gfannes/klepto/Proposal.md

&done

De massale aanval van laffe aliens op onze Mars basis kwam totaal onverwacht. Jij hebt het gelukkig wel overleefd, samen met enkele collega's en wat basis materiaal. Help je om snel iets in elkaar knutselen en het voortbestaan van de mensheid op Mars te garanderen? Neem best ook een mama of papa mee: terwijl jij wilde ideeën tegen de lichtsnelheid knalt, kan die voor snacks zorgen en effectief de handleiding lezen.

In deze workshop maken we een heuse Mars rover met een echte Rocker-Bogie ophanging op basis van [STEMFIE](https://stemfie.org/) 3D-geprint materiaal. De aandrijving komt van enkele gehackte servo motoren. Dit alles toppen we af met een kanon dat vol-automatisch NERF darts kan afvuren. Ten slotte sturen we heel de boel aan via de Fri3d badge met behulp van NRF24L01 draadloze communicatie.

Kortom, teveel life-hacks en leer momenten om op te sommen. Alles is compatible met STEMFIE zodat je thuis rustig verder kan bouwen/printen/uitvinden/...

Doe je het liever wat rustiger aan: geen probleem, je kan evengoed boerderijdiertjes in elkaar knutselen. We weten allemaal dat patatjes goed groeien op Mars, waarom geen paarden en koeien?

Of ben je eerder een looser? Ook goed: dan kan je helpen om wat aliens in elkaar te knutselen. Met een tril-sensor, servo en een [digispark](https://www.kickstarter.com/projects/digistump/digispark-the-tiny-arduino-enabled-usb-dev-board) gaat deze alien neer wanneer die geraakt wordt door een NERF pijl.
