gfannes/klepto/&.md

&&klepto

https://docs.micropythonos.org/

Printlijst: https://docs.google.com/spreadsheets/d/1lR1KDpJ_HNhGDXhQdjOyAJ3Ws1VXYitcTHIAmVLh5S0/edit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

Working name to make the link with 'Mars rover'.
Alternatives:
- Lupin

# Tasks &#1
- [ ] Batteryholder under 5x9 clashes with L-beam screws
- [ ] Freewheel must be locked
- [ ] Tilt motor platte 6x3 L
- [ ] Rondellen voor centrale as en as 0.5U langer
- [ ] 5x5L for boogie

# MarsRover
- 1x P 9x5x1
- 2x T 11x2x1
- 2x L 3x4x1
- 2x T 3x7x1
- Frontwheel
	- 2x Freewheel
	- 2x L 5x5x1
	- 4x/6x wheel
- 1x L 6x3x0.25
- Battery holder
- MotorMount-v2
- Shooter
- Bolt 5 for shooter
- Axle 10.5
- Rubberbands
- Wheelfixer drivemotors
- 2x wheel + wheelfixer voor dubbele banden

- [x] Design deftige bandjes
- [ ] Label esp32 with mac address
- [ ] Create equipment list
	- [x] Order striptang
	- Lijmpistool
	- Soldeerbout
	- Fijnbektang
	- Striptang
	- Cuttermes
	- Ductape
	- Fijn platte schroevendraaier
	- Multimeter
	- Schuifpasser
	- Batterijlader
	- Labovoeding
	- Papier
	- Balpennen
- [x] Bestel filament
- [ ] Charge batteries
- [ ] Draw cart design
- [ ] Create box per rover
- [ ] Spare parts
- [ ] Zoek alle badges
- [ ] Solder JST to batterypacks
- [ ] Design target
