gfannes/klepto/Rover.md

&#5

# Suspension
- Rocker-bogie suspension of Mars rover
	- Diff with ropes: at 5min in https://www.youtube.com/watch?v=ern5a-jvdxY&t=332s
	- https://www.youtube.com/watch?v=dts8WvfQUDg
	- Too complex, couple front and rear wheel with rubber band to create basic suspension

# Parts
- [ ] Make complete rover body
- 2x 5x9 square
- 4x 3 beam thread with only middle hole
- 2x 13 beam
- 4x wheel
- 2x T1 wheel fixer
- 2x T1 motor mount
- 4x angle bracket
	- [ ] bit smaller to avoid hindering the base plate
- 4x poullies
- 2x4 1.5U screw and nut
- 2x axle fixer
- 1x axle
- 8x 1.5U screw for angle brackets
- 4x 1.25U screw
- 2x 3 beam

# Splitnut
- Sphere 8.4
- Slit: 12.8x3.4 6x3.8,B0.7 3x4.8,B1.5
- Cylinder: 6.8
- Profile: 12.8x5.4 4x4.4 from bottom

# Wheel fixer
- [?] How can we fix the wheel to the fixer
	- Hotglue?
- Outer cylinder 12.5
- 4 cuts with cylinder 10 with center at distance 10
- Depth Wheel: 9
- Axle length: 8
- Axle width: 5.3 x 3.6 => 5.5 x 3.9
- Axle smallhole: 2 => 2.2
- Length: 8+9
- Fillet

# STEMFIE
- https://github.com/Cantareus/Stemfie_OpenSCAD

# Ledger
## Prototype 2026-06-10
- [ ] 5xAA NiMH works but is depleted after 10min, either due to the MG996R or the battery pack being too old. Test this.
- [ ] Rubber bands are necessary for the wheels to have enough grip. Test with TPU and hotglue.
	- [?] Two temp filament
