gfannes/klepto/Comms.md

- ESP-NOW is a wireless protocol between ESP-WROOM-32 MCUs
	- 600m range
	- [x] Test this

- [x] Check comms capability:
	- Arduino + NRF24L01: https://www.youtube.com/watch?v=7rcVeFFHcFM
	- Issues with NRF24L01: https://www.youtube.com/watch?v=Z7_Cy66Vnrc
	- https://www.instructables.com/NRF24L01-Tutorial-Arduino-Wireless-Communication/
	- https://howtomechatronics.com/projects/diy-arduino-rc-transmitter/
