gfannes/klepto/Turret.md

- Drive 2 130-size DC motors
- Switch them with an N-MOSFET or relay
# Flywheel
- Motors: 130-size DC
	- 3-6V, 1.2W, 17kRPM
	- Requires a capacitor
	- https://www.amazon.com.be/-/nl/Fasizi-10-stuks-DC-Arduino/dp/B09Z2B1F1V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
- N-MOSFET
	- IRLZ44N
		- https://opencircuit.be/product/irlz44n-mosfet-55v-47a
	- FQP30N06L
	- IRLB3034 (very low RDS(on), overkill but excellent)
	- IRLB8748PBF (very low RDS(on), overkill but excellent)
	- IRL540 works but get a bit hotter
	- Better not use a TIP120 darlington NPN since that loses 1V

# Nerf cannon with fuel
- https://makerworld.com/en/models/2179007-alcohol-nerf-cannon#profileId-2364657

# Nerf turret
- https://www.youtube.com/watch?v=3Ma5ZCZVQRs
- https://www.youtube.com/watch?v=ZnJ6_IrmszU
