gfannes/klepto/docs/index.md

# Rover build plan

## Shooter

### Shooter arm prepareren

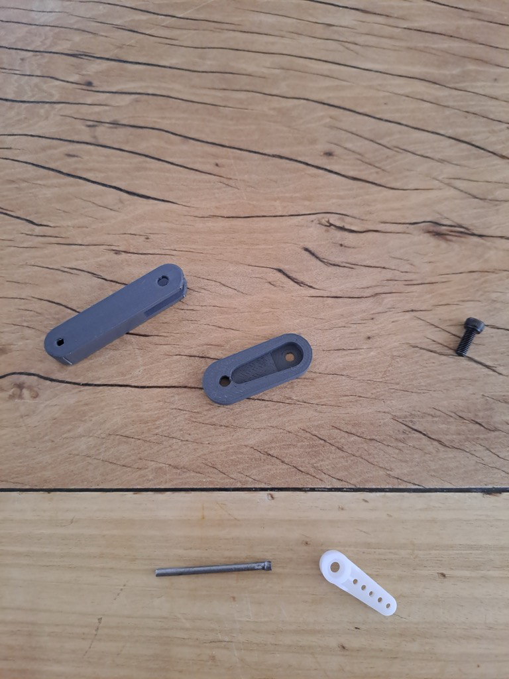
[picture p1: docs/img/A_s_05.jpg]

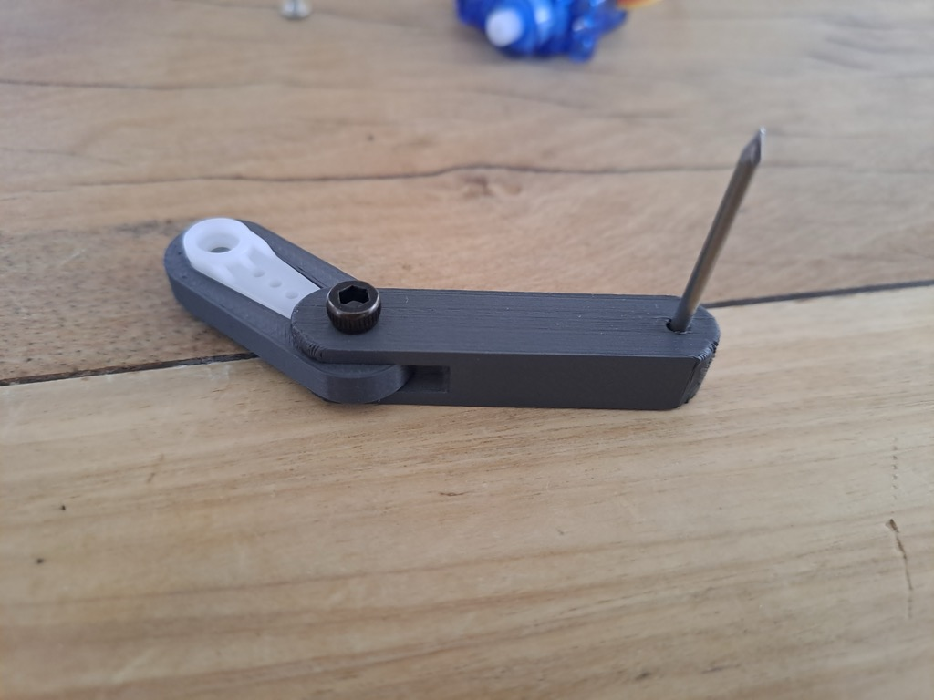
[picture p2: docs/img/A_s_06.jpg]

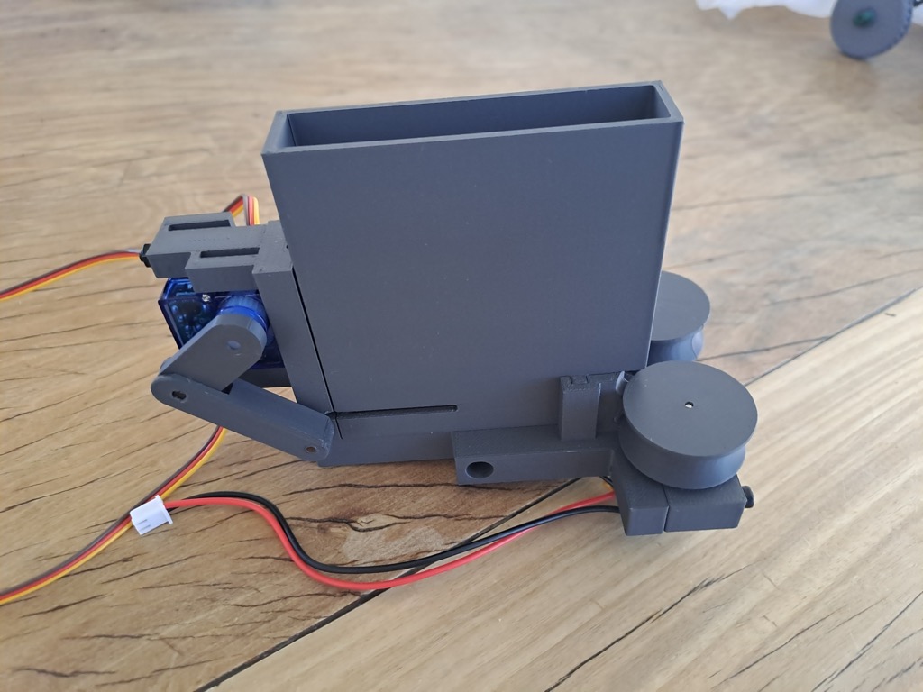
[picture p3: docs/img/A_s_07.jpg]

* Nagel opwarmen met aansteker om goed vast te smelten
    * Oppassen voor de vingers!!

### Servos aansluiten

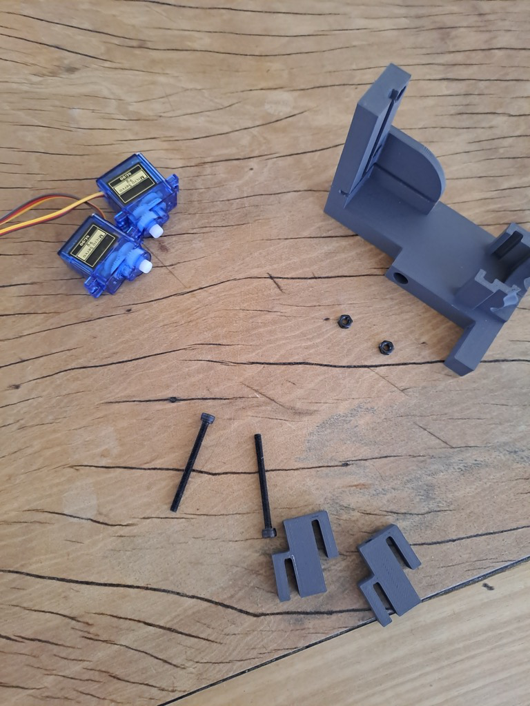
[picture p4: docs/img/A_s_00.jpg]


* Lange M3 bouten gebruiken (35 mm)

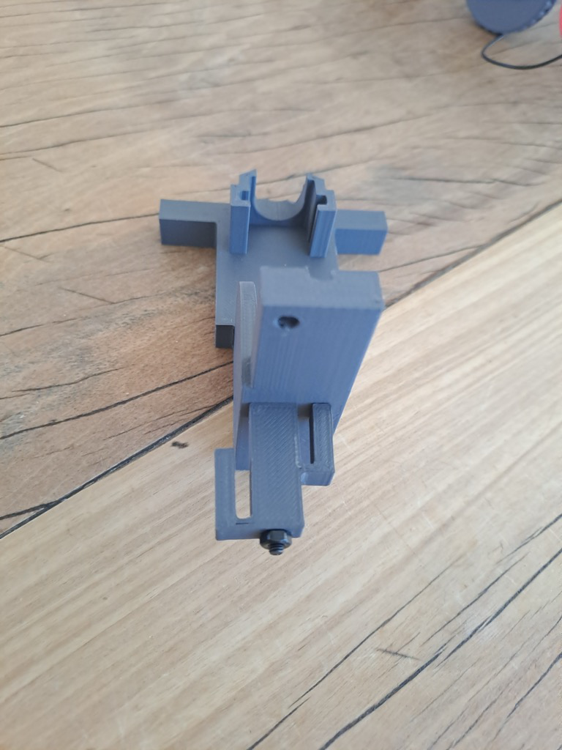
[picture p5: docs/img/A_s_01.jpg]


* Oppassen, de cactussen om de servo's te blokkeren zijn fragiel

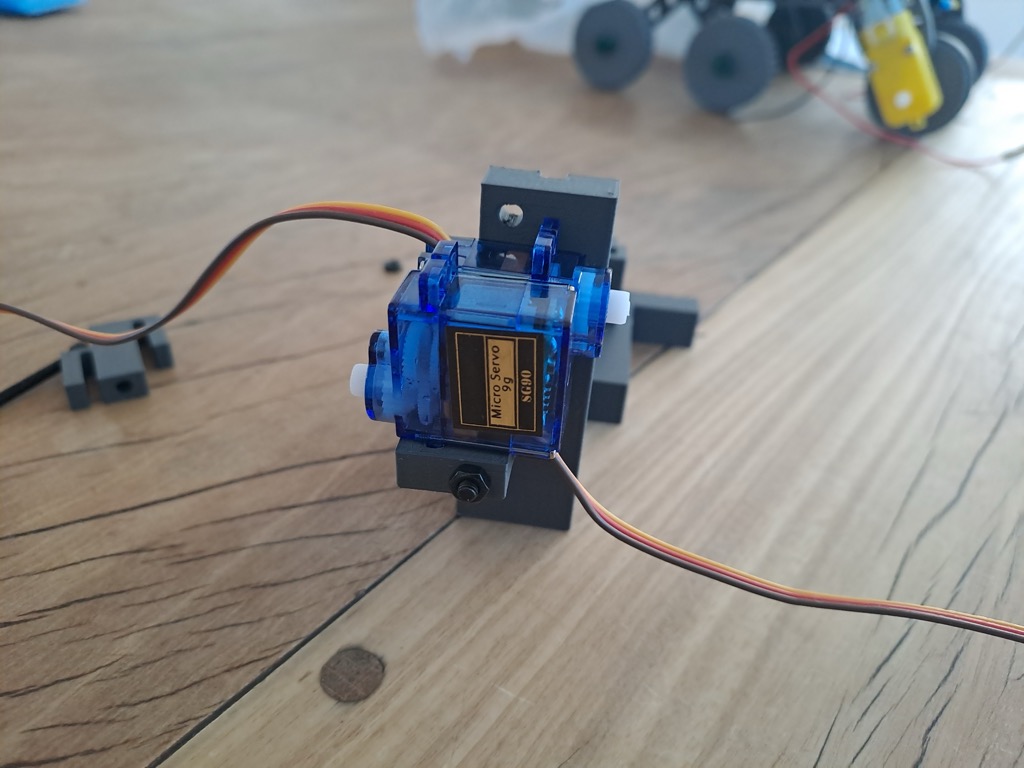
[picture p6: docs/img/A_s_02.jpg]


* Servo's correct positioneren

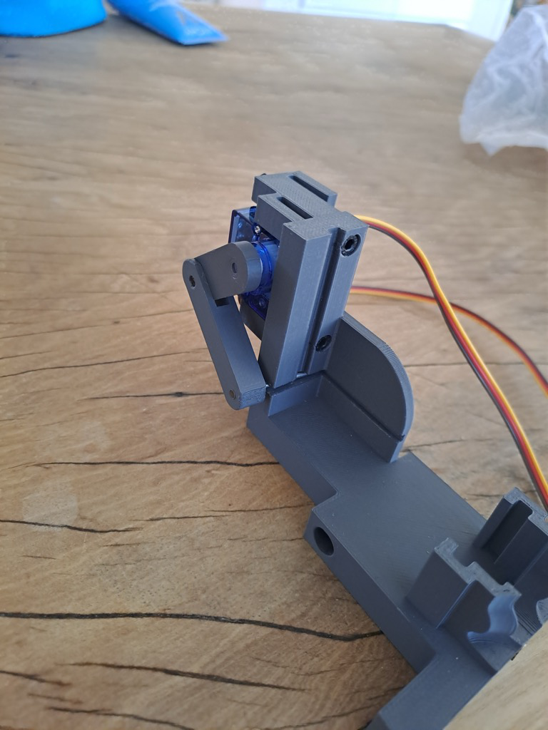
[picture p7: docs/img/A_s_03.jpg]


* Zorg dat de de ronde koppen van de M3s helemaal in de shooter base zitten

### Flywheels plaatsen

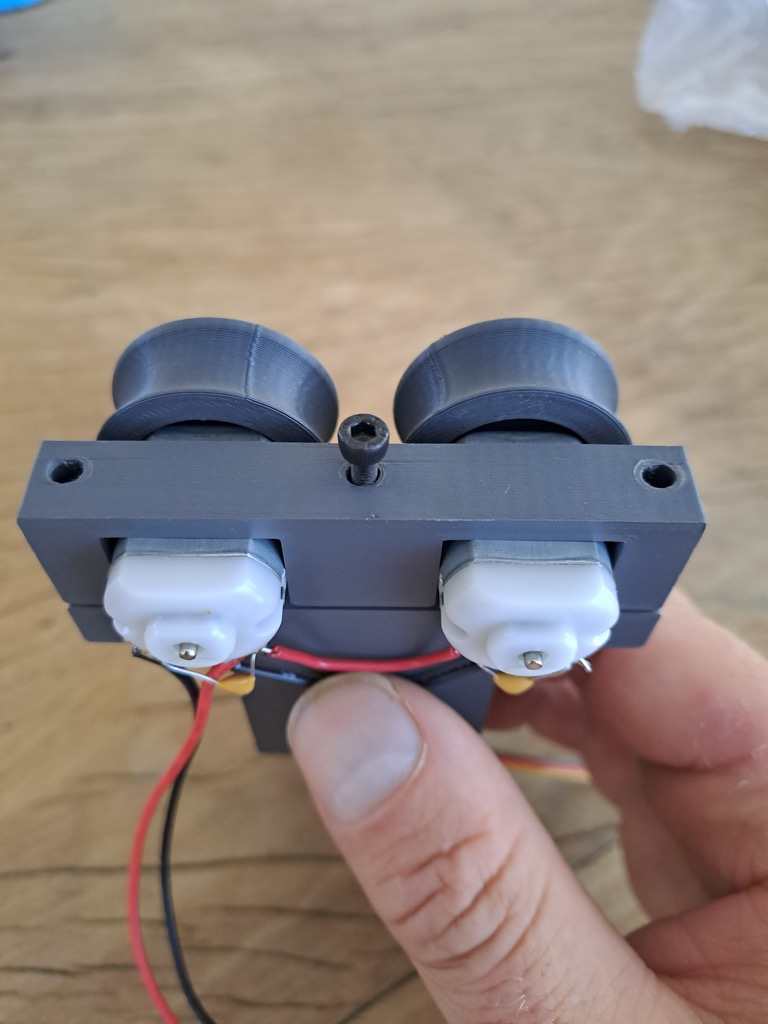
[picture p8: docs/img/A_s_04.jpg]


* Zorg dat de flywheels vrij kunnen draaien (test ook eens met de nerf pijltjes cartridge)

## Rocker arms

In tweevoud natuurlijk

### Aandrijf motoren

M3 van 25

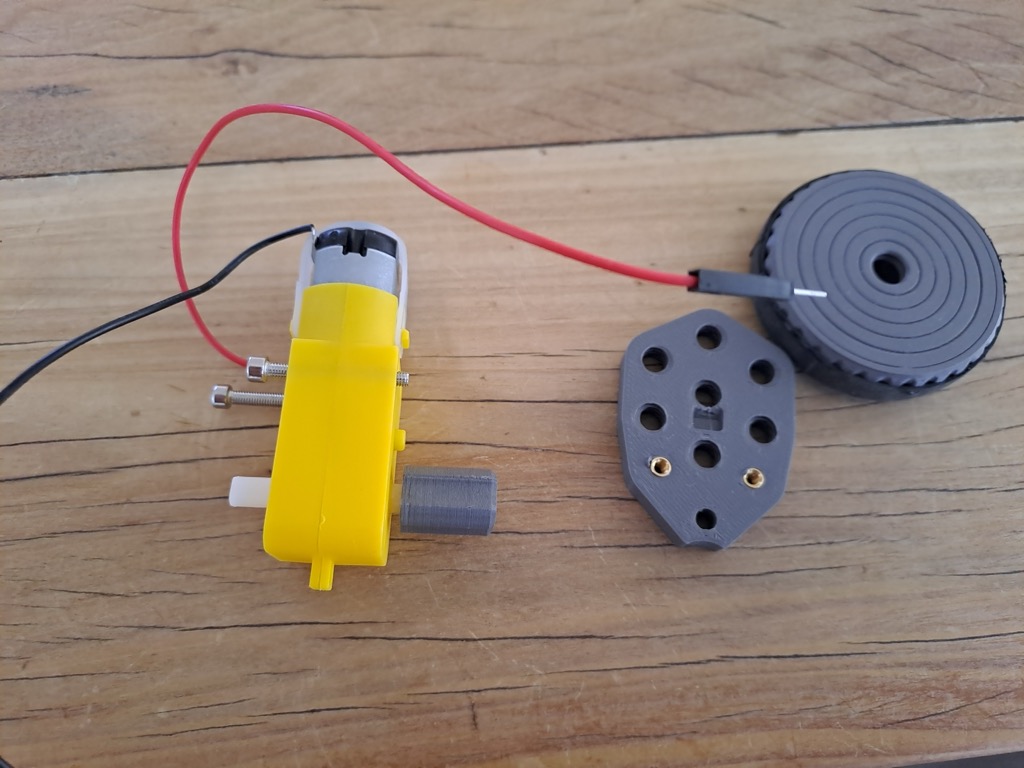
[picture p9: docs/img/B_m_00.jpg]

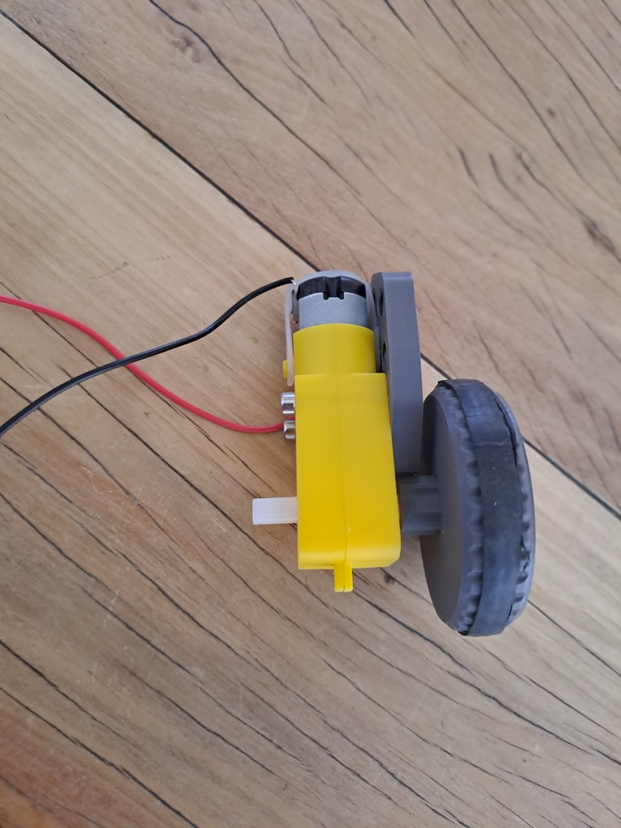
[picture p10: docs/img/B_m_01.jpg]


### Rocker wheel arms

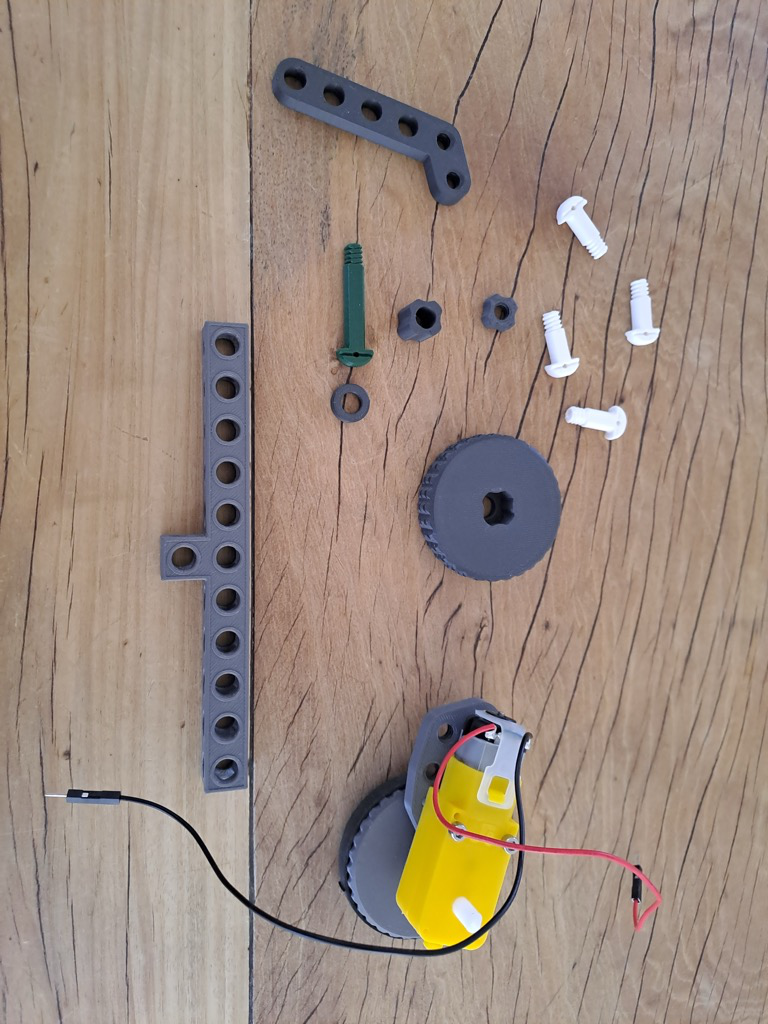
[picture p11: docs/img/B_sb_01.jpg]

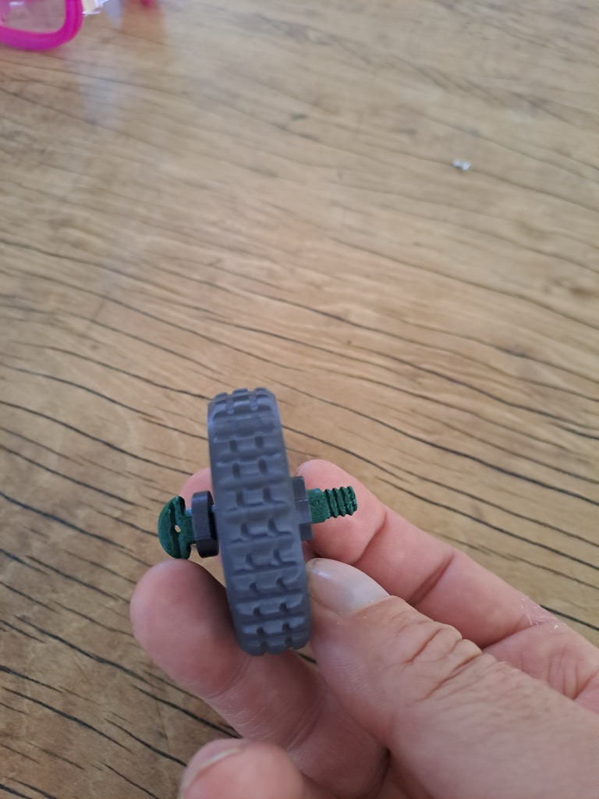
[picture p12: docs/img/B_sb_03.jpg]

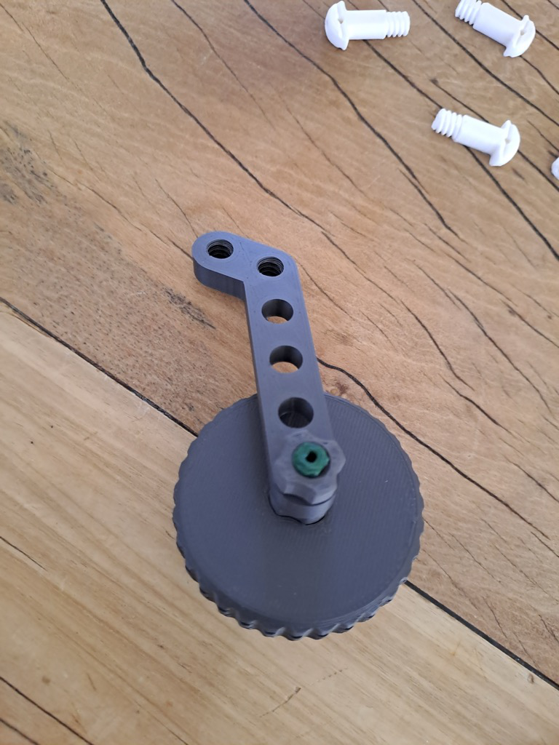
[picture p13: docs/img/B_sb_04.jpg]

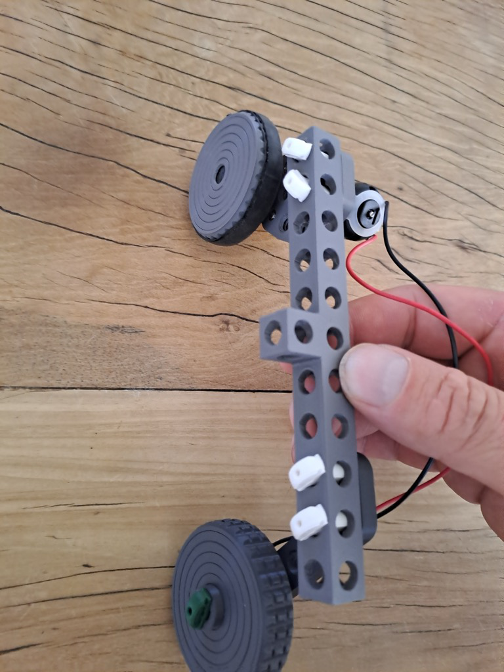
[picture p14: docs/img/B_sb_05.jpg]


### Kwalletjes

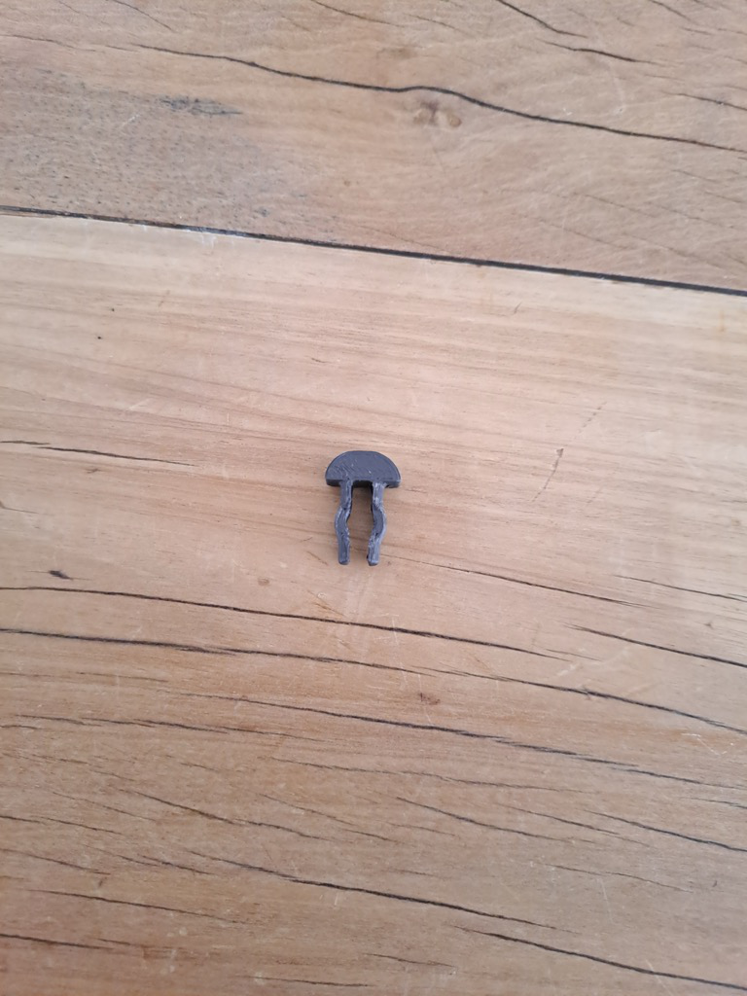
[picture p15: docs/img/kwal.jpg]


* Zorgt ervoor dat we pinnetje kunnen vastdraaien in een gatje
* Goed kijken, heeft een dunne en een dikke kant
    * Positionering is dus belangrijk

### Rocker suspension arms

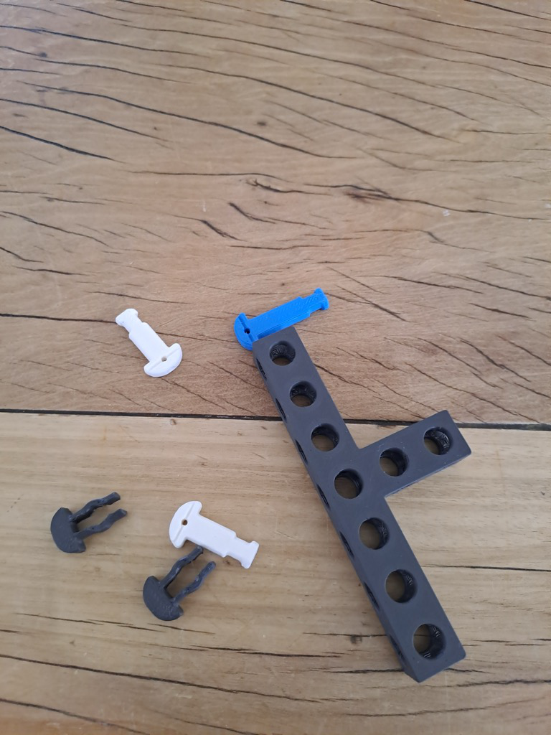
[picture p16: docs/img/B_fb_00.jpg]

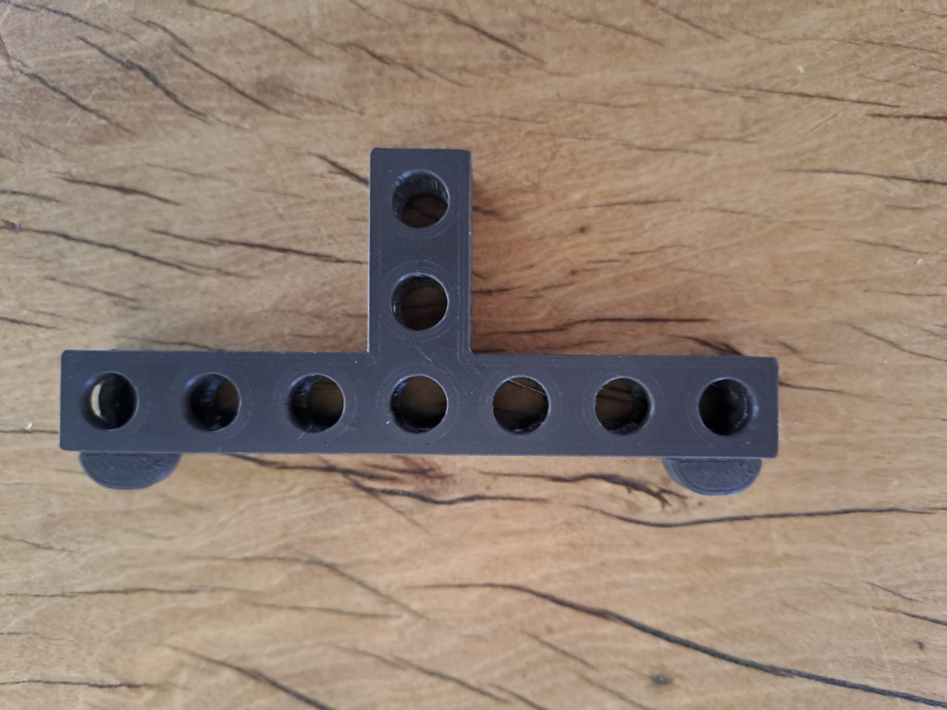
[picture p17: docs/img/B_fb_01.jpg]

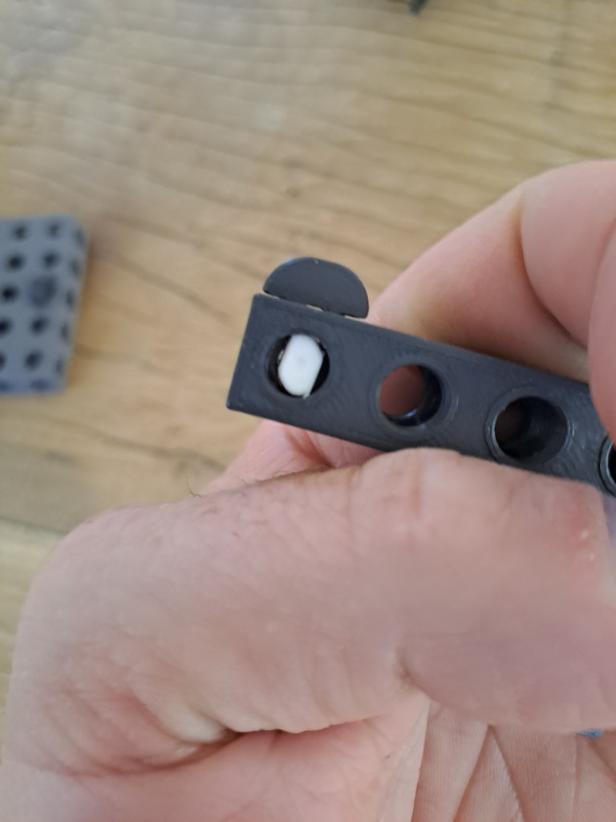
[picture p18: docs/img/B_fb_02.jpg]

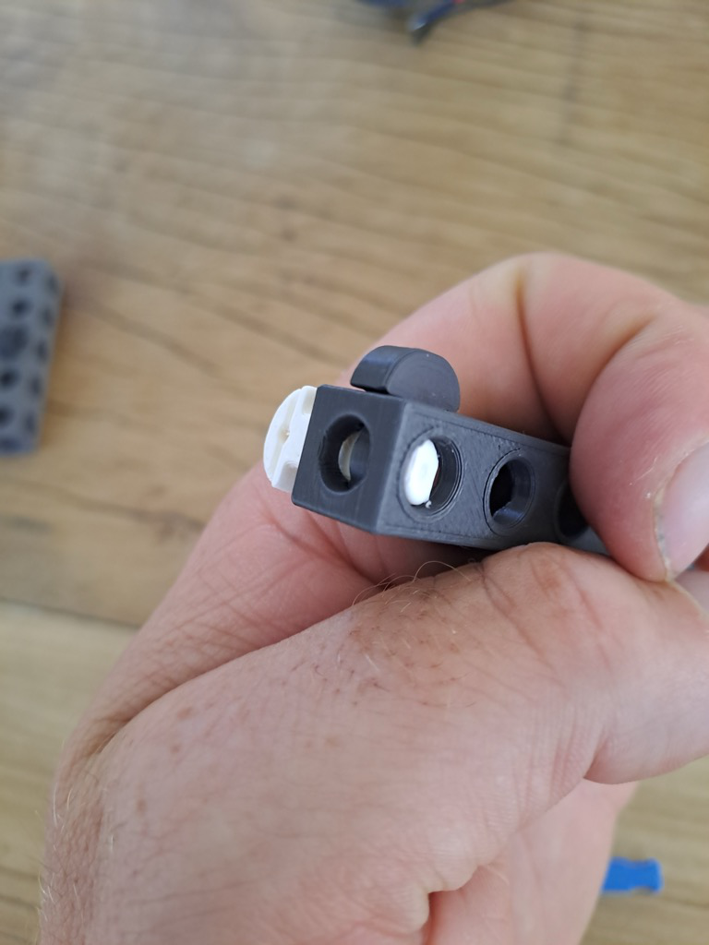
[picture p19: docs/img/B_fb_03.jpg]


* Witte pinnetjes steken wat uit, dienen om de vering op vast te maken

## Main body

### Shooter connection

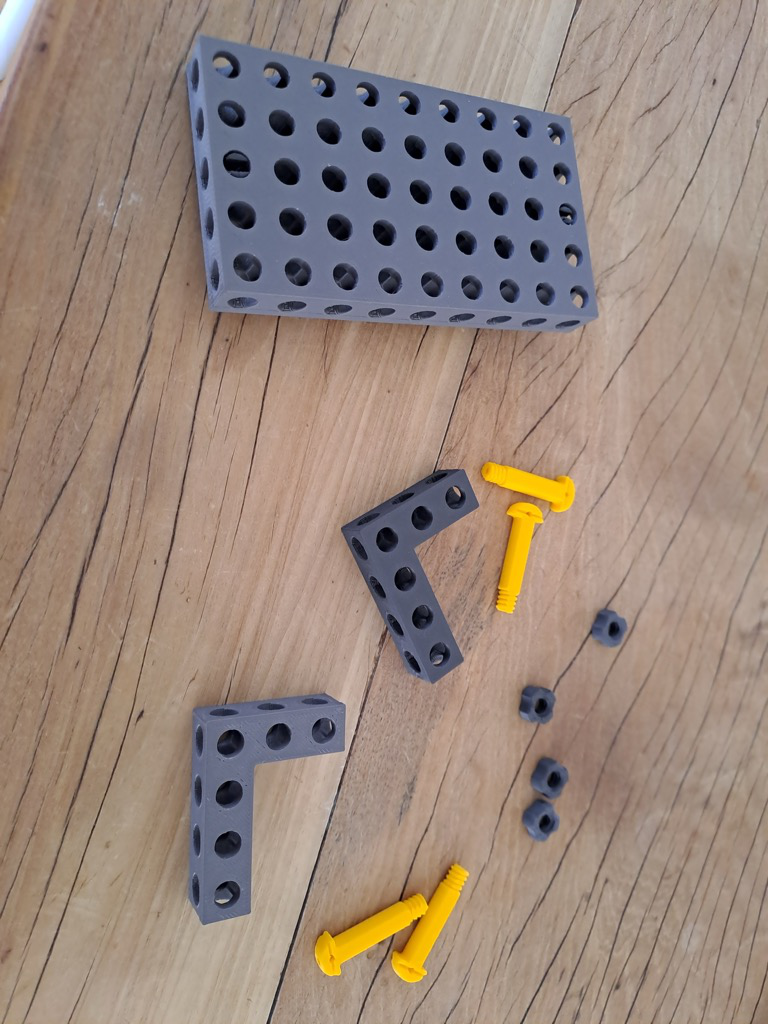
[picture p20: docs/img/C_bp_00.jpg]

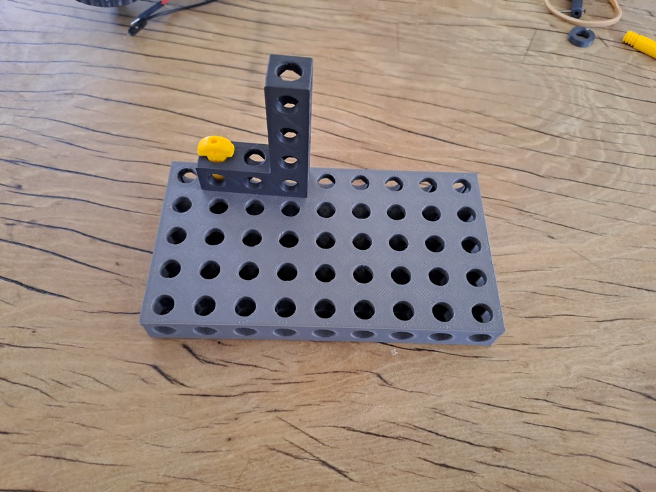
[picture p21: docs/img/C_bp_01.jpg]

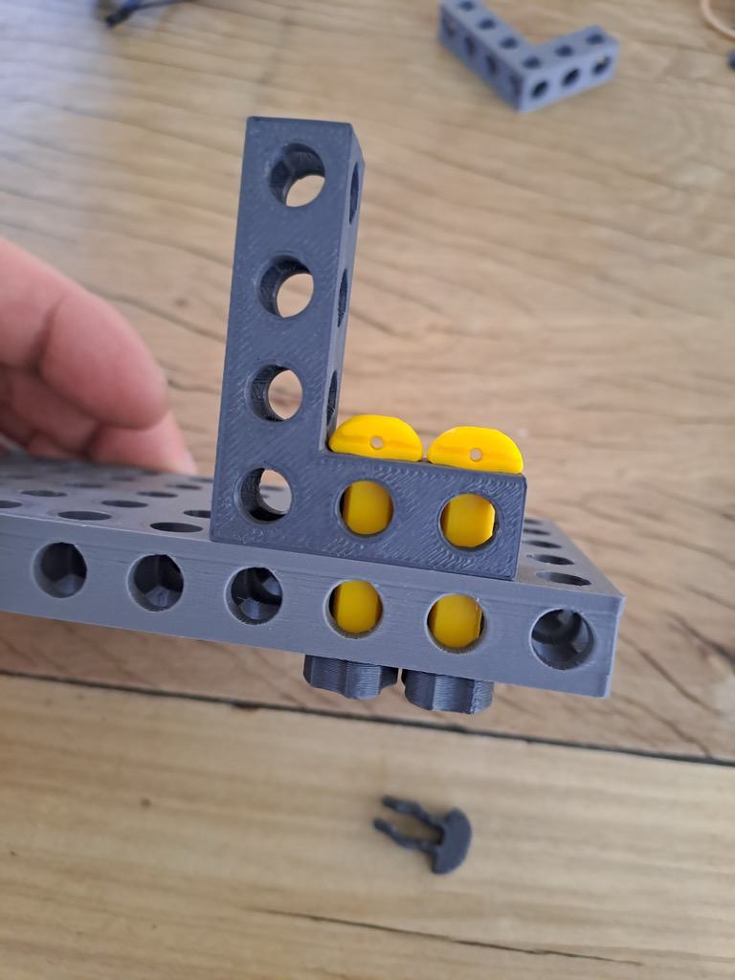
[picture p22: docs/img/C_bp_02.jpg]

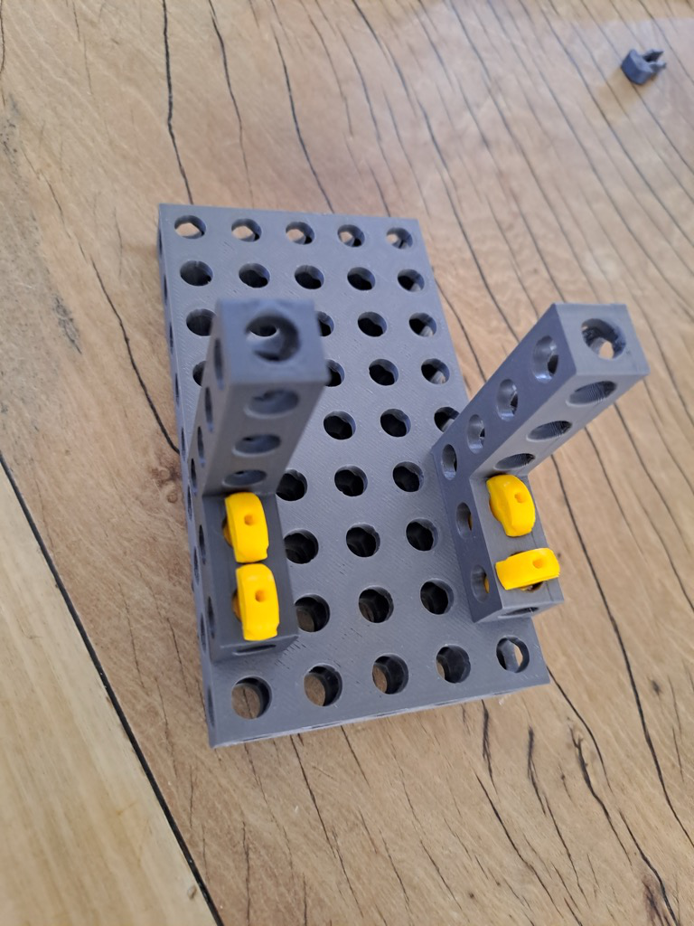
[picture p23: docs/img/C_bp_03.jpg]


### Rocker suspension arms
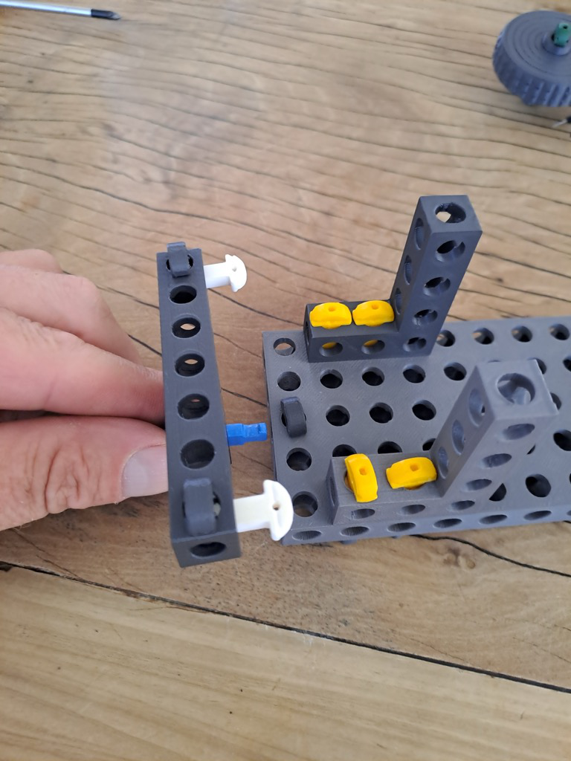
[picture p24: docs/img/C_bp_04.jpg]

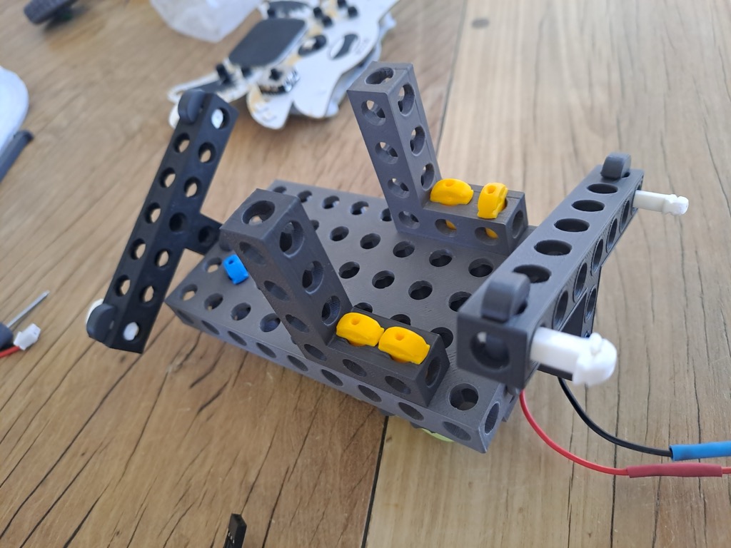
[picture p25: docs/img/C_bp_05.jpg]


### Tilt servo connector preparation
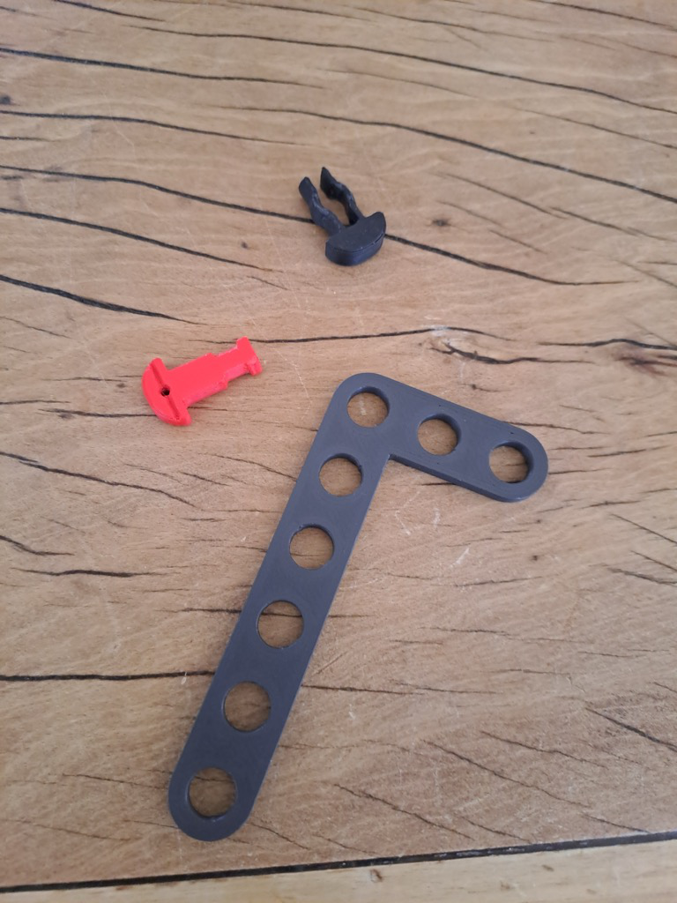
[picture p26: docs/img/C_bp_06.jpg]

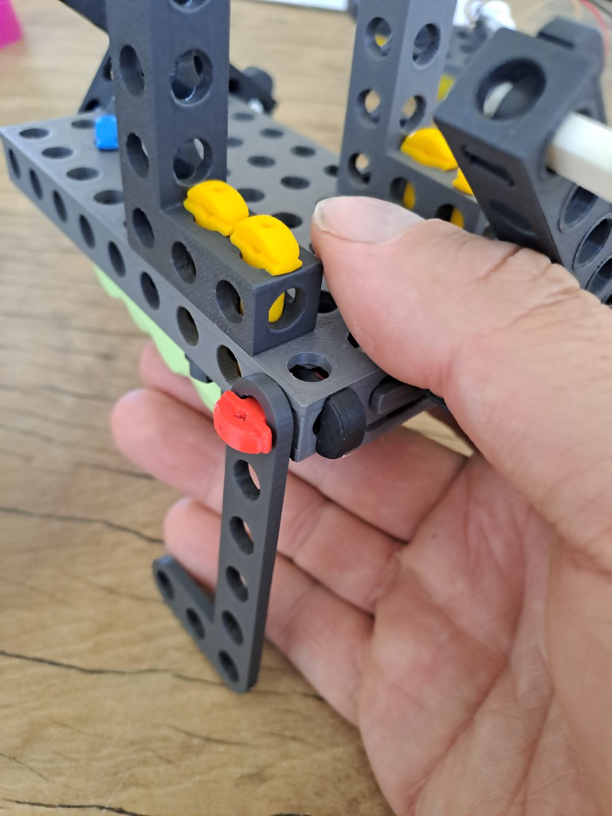
[picture p27: docs/img/C_bp_07.jpg]


### Rocker arms

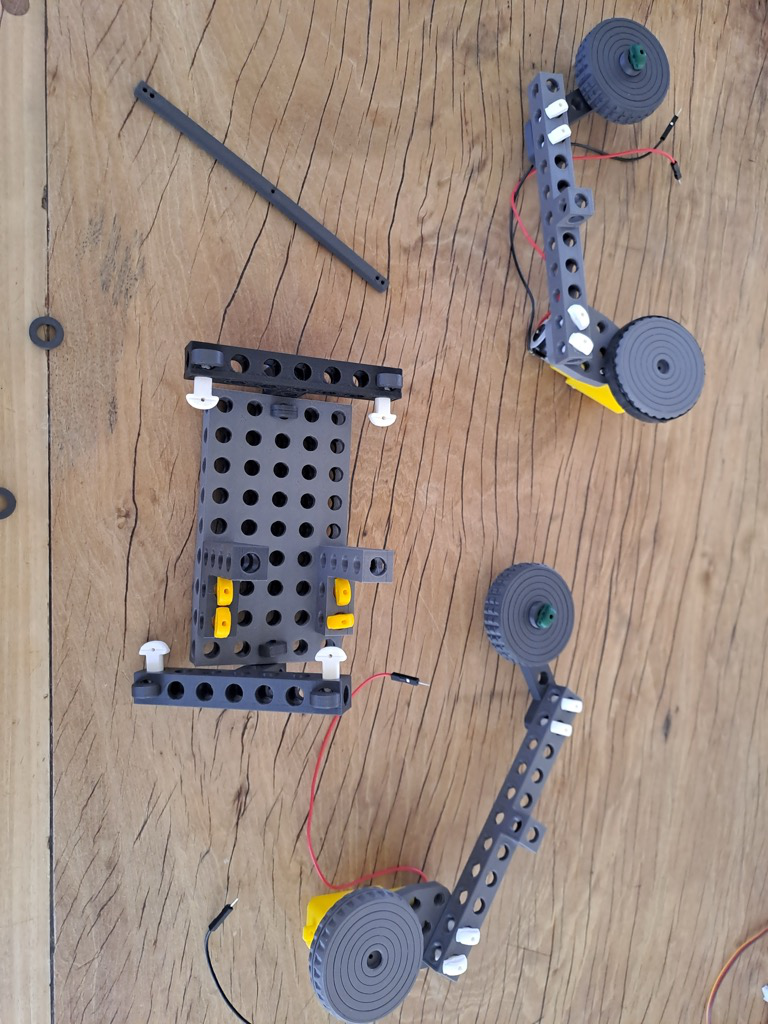
[picture p28: docs/img/C_sb_00.jpg]

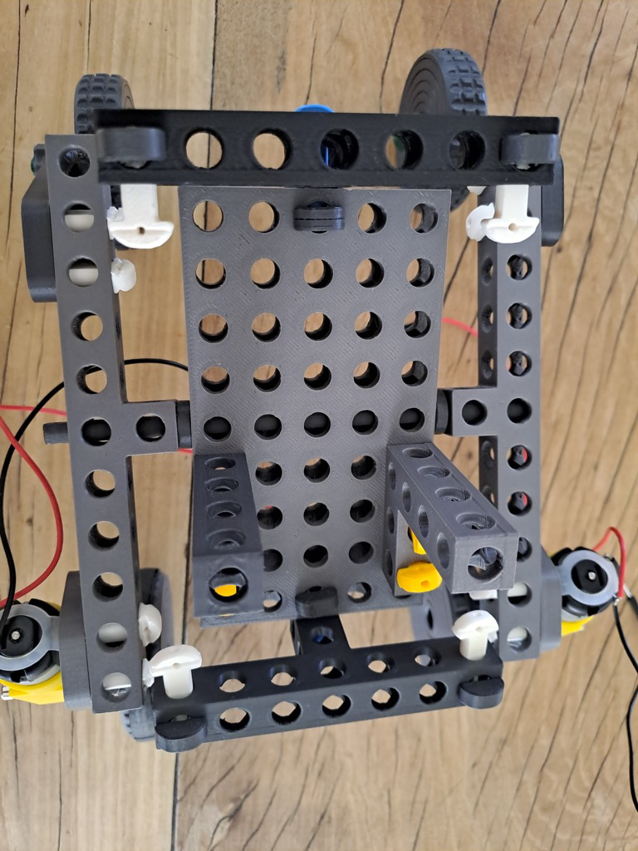
[picture p29: docs/img/C_sb_01.jpg]

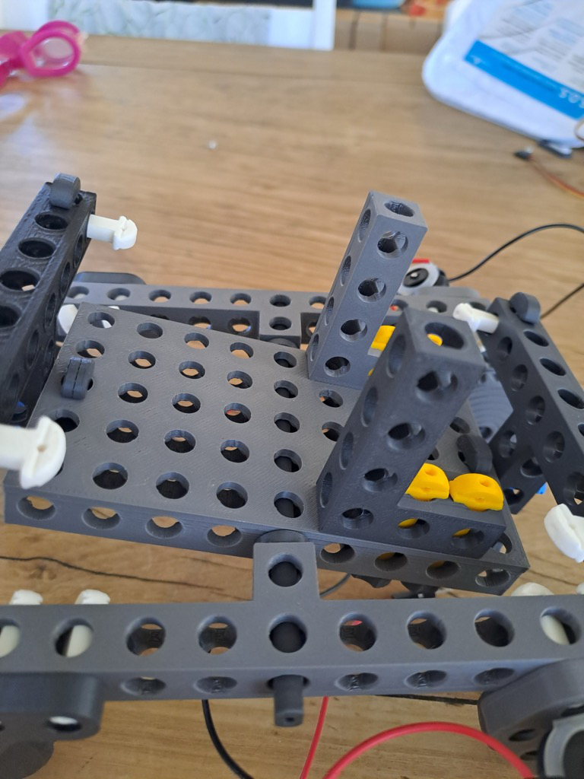
[picture p30: docs/img/C_sb_02.jpg]

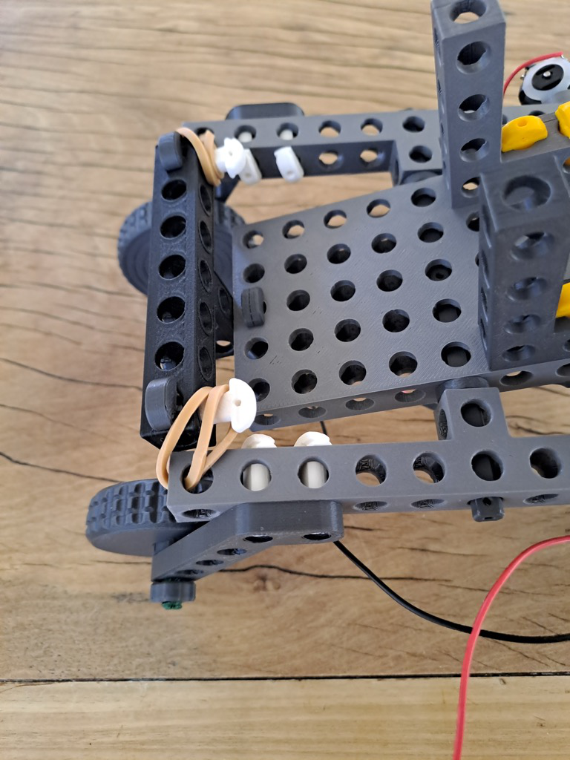
[picture p31: docs/img/C_sb_03.jpg]



 * Zorg dat de vering niet te vast zit

## Batterijhouder

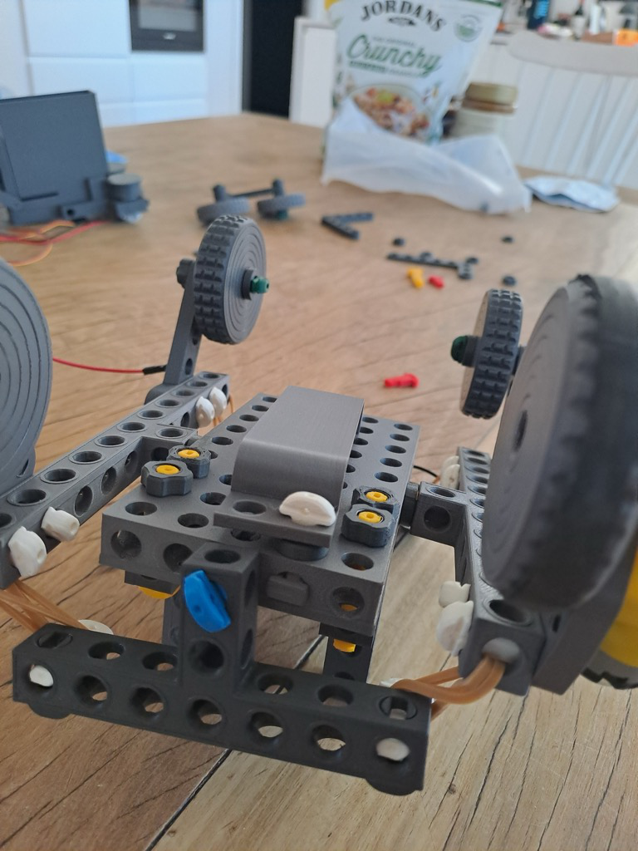
[picture p32: docs/img/E_01.jpg]

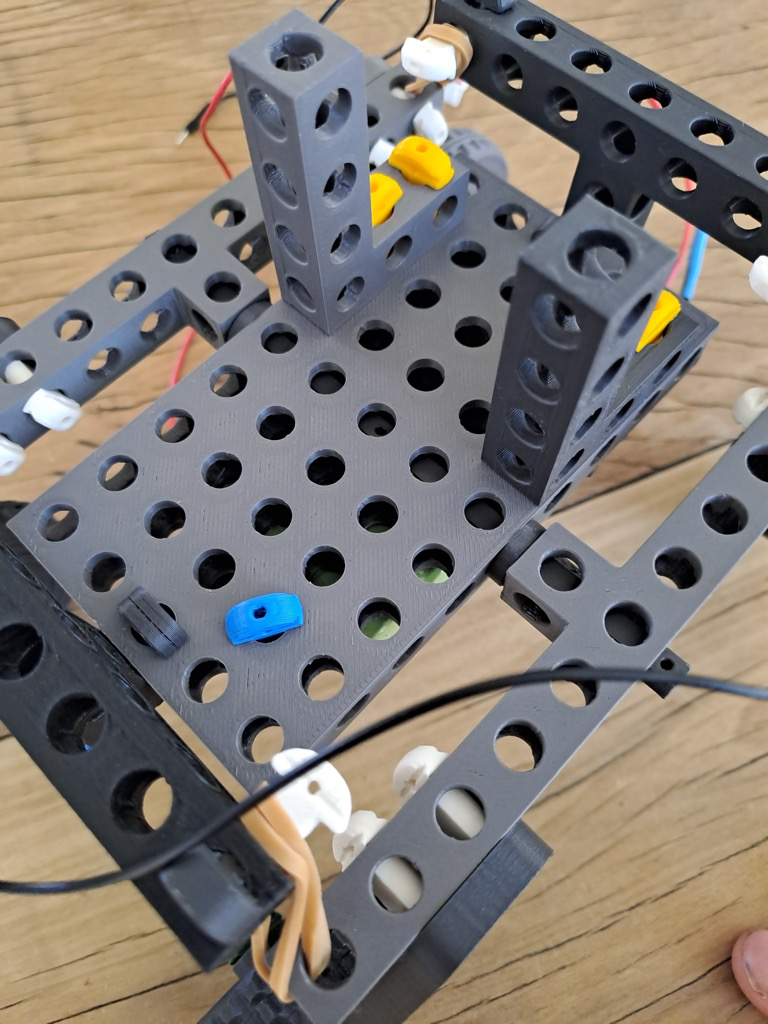
[picture p33: docs/img/E_02.jpg]

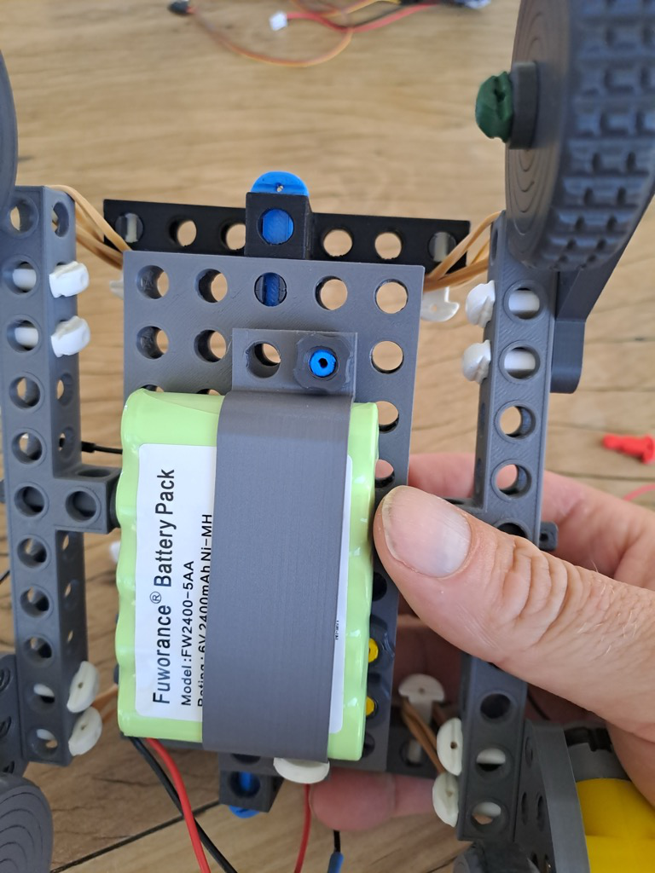
[picture p34: docs/img/E_03.jpg]


## Electronica

### Overview

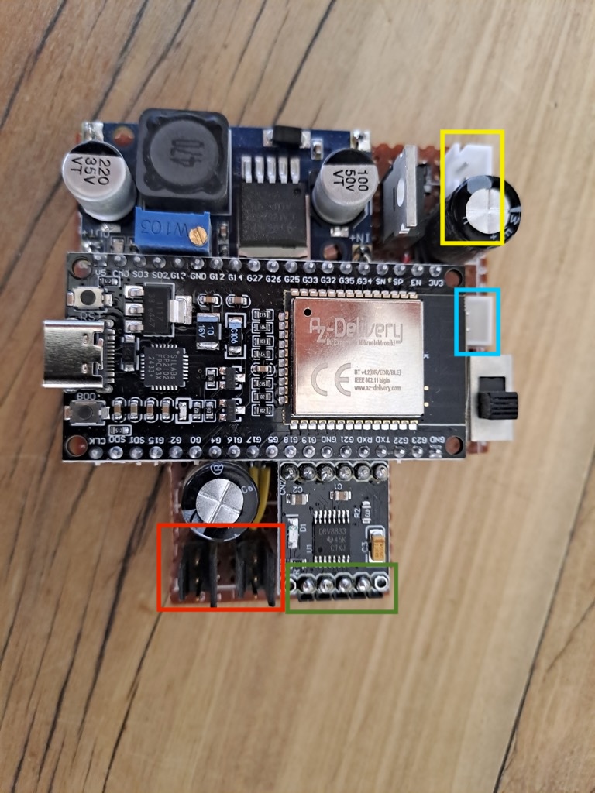
[picture p35: docs/img/D_00.jpg]


* Rood: Servos
    * Gele connector richting chip!!

* Groen: Motoren
    * rood, zwart, leeg, zwart, rood

* Geel: Flywheels

* Blauw: Batterij
    * allerlaatste, zorg dat de power uit staat

### Steps

* Flashen van test programma
* Connecteren van alle onderdelen en testen
* Mac address van esp en badge opzoeken 

## Shooter plaatsen

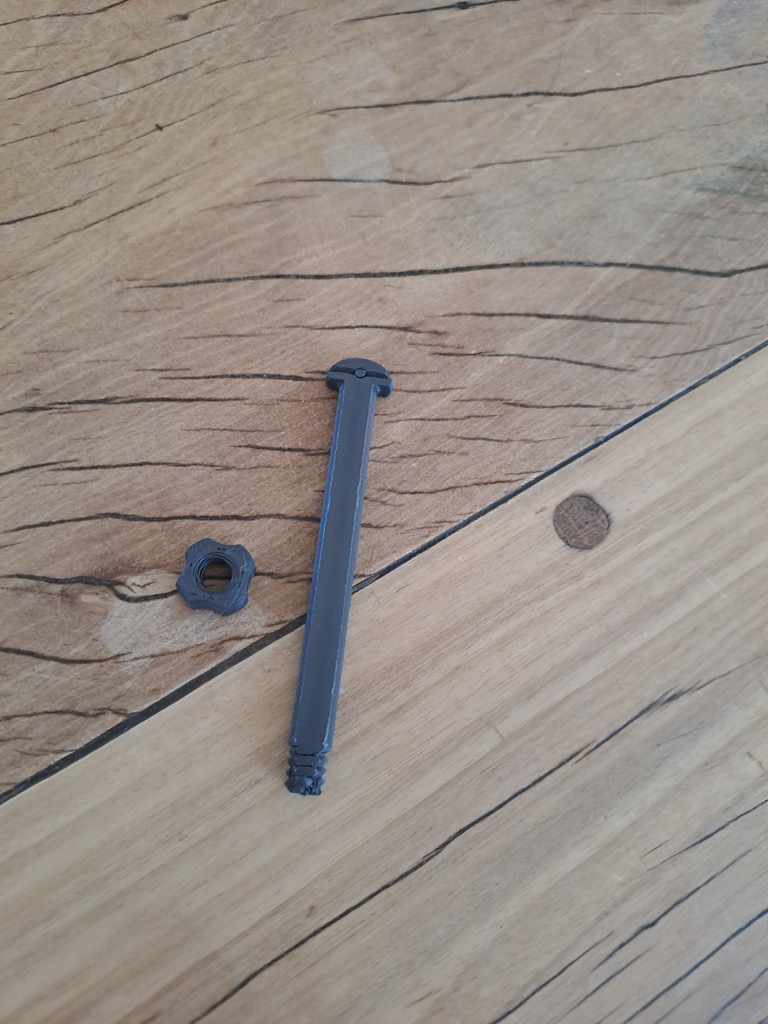
[picture p36: docs/img/F_00.jpg]

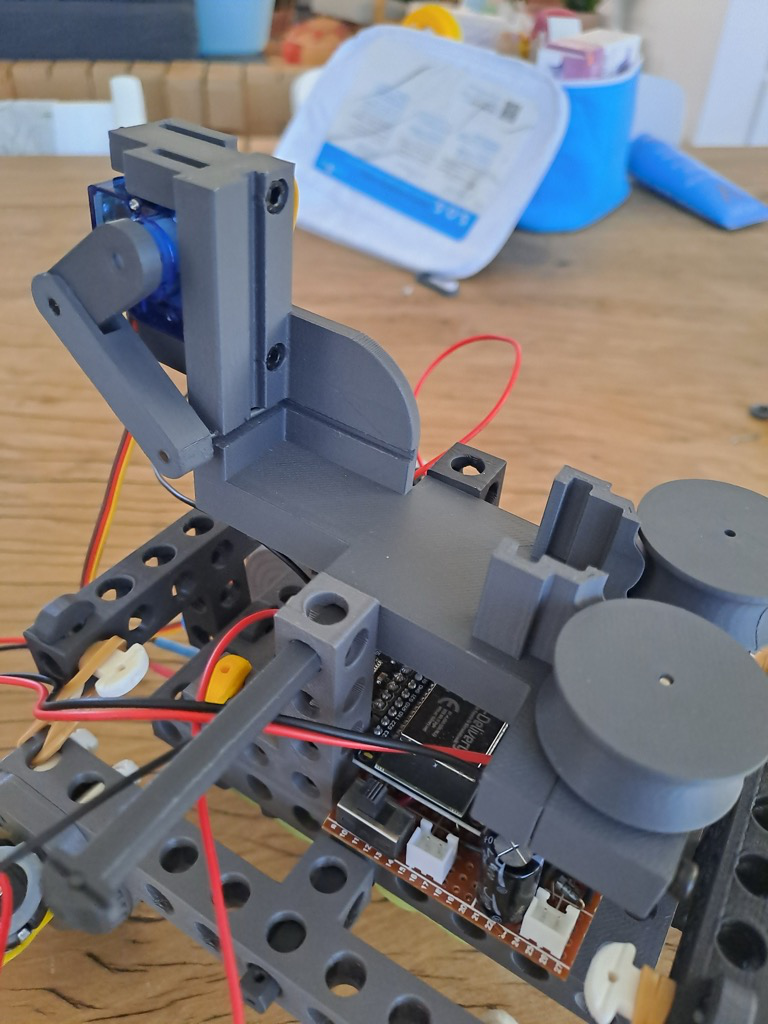
[picture p37: docs/img/F_01.jpg]

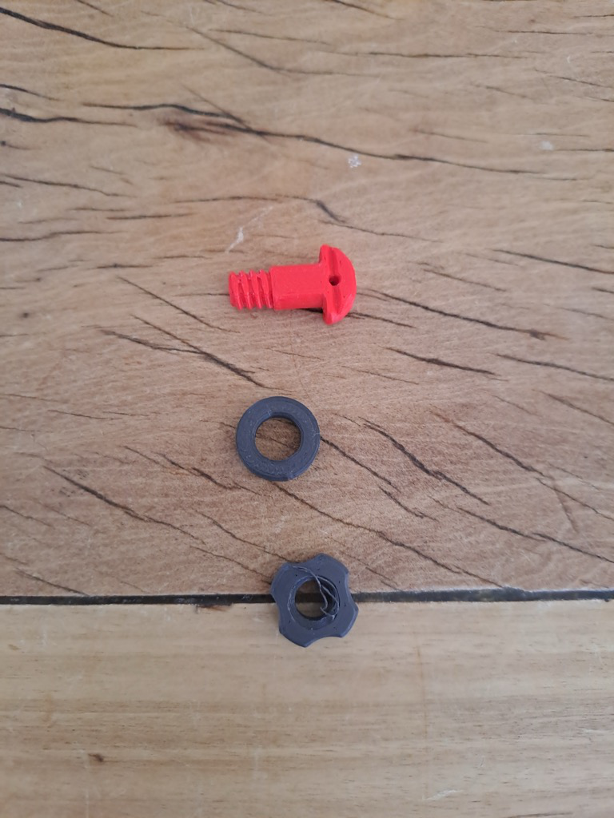
[picture p38: docs/img/F_02.jpg]

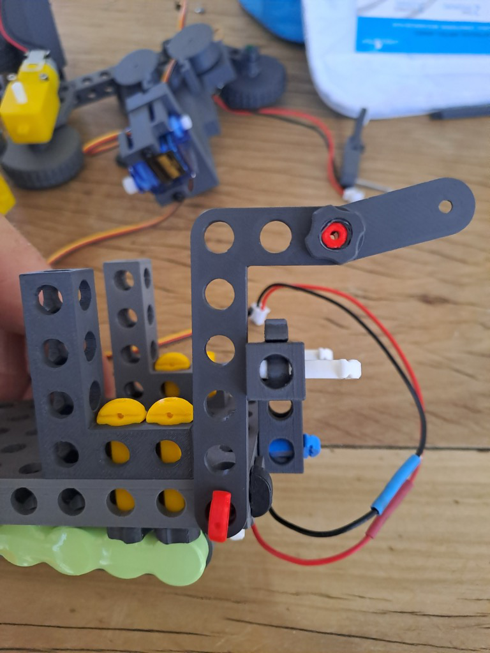
[picture p39: docs/img/F_03.jpg]

 * Zorgt voor connectie met tilt servo


## Alles aansluiten

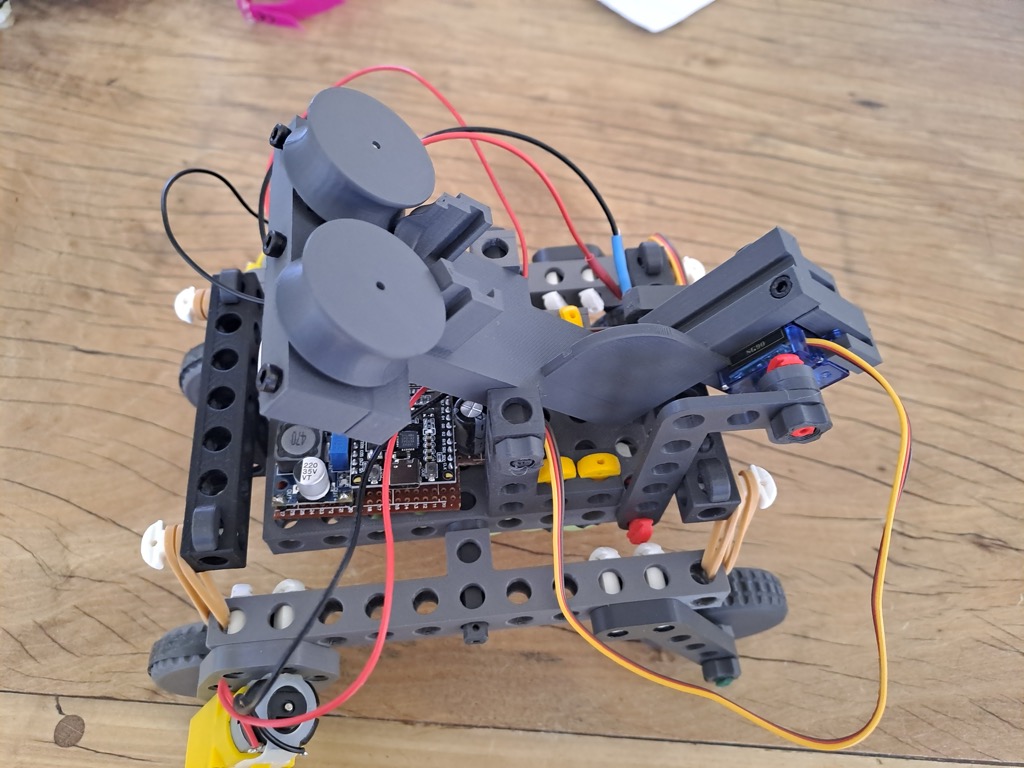
[picture p40: docs/img/Z_00.jpg]
