gfannes/klepto/pcb/&.md

&&pcb &#1

- [*] Solder corner headers on T1 motors
- [ ] Design spinnenkop voor onder 5x5
- [ ] Tune buck convertors to 5V
- [/] Test board with `test_5x5`
	- [x] Servos
	- [x] T1 motors
	- [!] Mosfet causes ESP to crash
		- [/] 470–1000 uF electrolytic across battery + and -, near the motor/MOSFET
		- [ ] Keep the 104 capacitor directly across the motor
		- [/] 100–220 Ω between GPIO25 and gate
		- [ ] 10 kΩ from gate to source/GND
		- [/] Prefer a Schottky flyback diode such as 1N5819; the 1N4006 is slow
- [/] Add powerswitch
	- [ ] Find one that can sit on a wire between the battery
- [-] Angled JST connector for battery
- [-] Angled servo connector

# Soldering
- [ ] Drill holes before soldering
	- [ ] Also drill middle-holes
- Yellow: 20mm, 16mm
- Black: 30mm, 33mm, 26mm

# Test app
- See `test_5x5/test_5x5.ino`
- [x] Install `ESP32 Dev Board` from Arduino IDE v2.3.10
	- Select `/dev/ttyUSB0` VID 0x10C4 PID 0xEA60
	- Select board `ESP32 Dev Module`
	- Install `ESP32Servo` library
	- [x] Add diode and gate driver to IRLZ44N

# DONE Create PCB layout &#3
- 98mm long, 60mm wide, holes 50mm
- Power ESP32 from buck-OUT+/OUT- into ESP32-V5/GND at 5V
- GPIO pins: 13, 14, 16, 17, 18, 19, 21, 22, 23, 25, 26, 27, 32, 33
- 1x DC 130 motor via mosfet
	- Gate connected to G23
- 1x DRV8833
	- IN1 connected to G22
	- IN2 connected to G21
	- IN3 connected to G19
	- IN4 connected to G18
- 2x servo
	- With 1mF capacitor
	- Signal connected to G17 and G16
- Holes to mount PCB

# Parts
- Battery 5x1.2 NiMH
	- 6V, 7V when fresh
	- 12Wh if each cell is 2000mAh
- Servo SG90/SG92R
	- max 0.9A 6V, signal can be 3V3
	- connect to Buck
- DRV8833
	- signal can be 3V3
	- connect directly to battery
	- 6x7
- IRLZ44N
	- signal can be 3V3
	- connect directly to battery
	- IRFZ44N is not good for 3V3
- LM2596S buck convertor
	- 5V output, 2A continuous 3A peak
	- IN- and OUT- from buck convertor are the same
	- 17x8
- ESP32
	- 5V 0.5A
	- 11x19

# Power train
- Battery
	- Buck convertor
		- ESP32
		- Servo, best with 1mF capacitor, drive separate from other servo
		- Servo, best with 1mF capacitor, drive separate from other servo
	- DRV8833
	- IRLZ44N

# Ledger
- PCB drawing tools
	- DICLC
	- https://fritzing.org/
		- ESP32 module: https://forum.fritzing.org/t/esp32s-hiletgo-dev-boad-with-pinout-template/5357?u=steelgoose
