gfannes/klepto/docs/img/C_sb_05.jpg

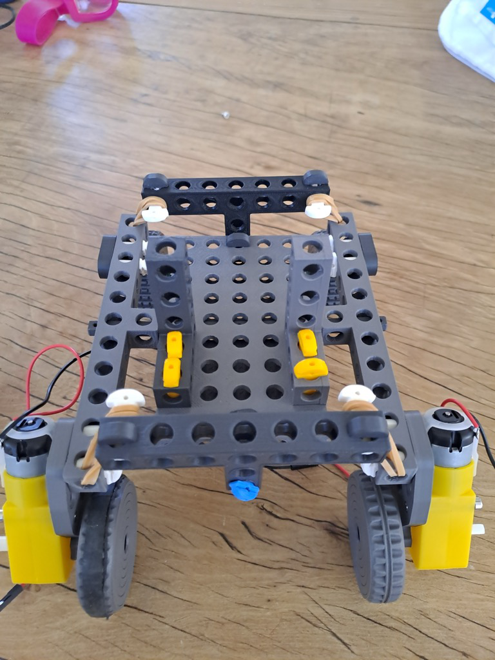
docs/img/C_sb_05.jpg
