gfannes/klepto/docs/img/fb_04.jpg

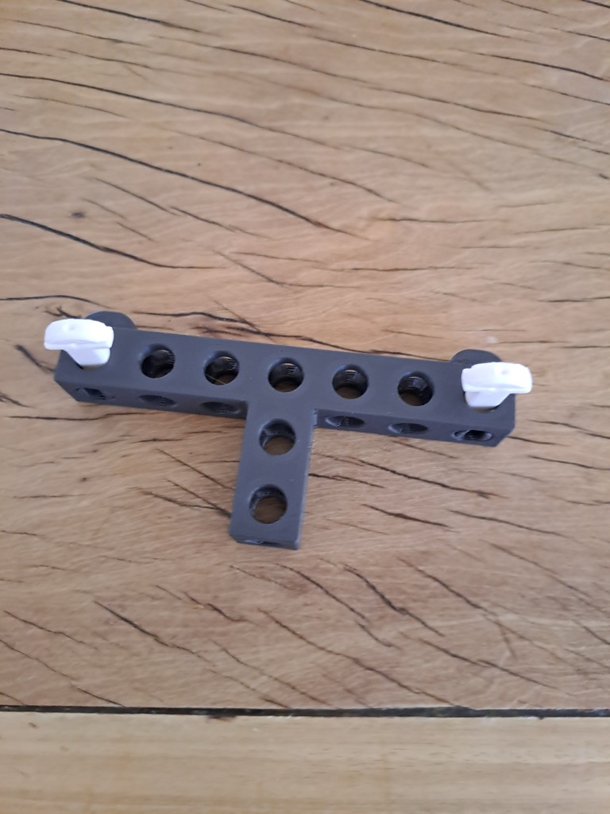
docs/img/fb_04.jpg
