gfannes/klepto/docs/img/fb_05.jpg

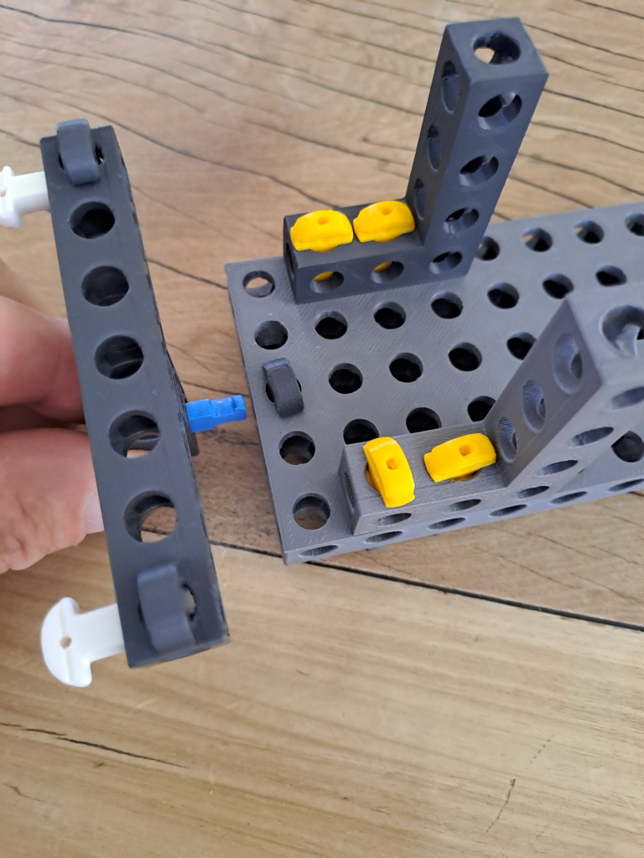
docs/img/fb_05.jpg
