gfannes/klepto/qr.png

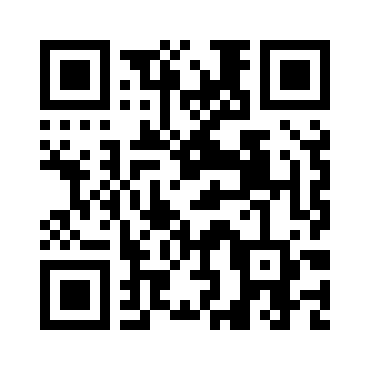
qr.png
