gfannes/klepto/BOM.md

# Per rover
- Control board
- Battery pack
- 2x DC motor 130 size
- 100nF capacitor for over motor
- Rubber bands
- Stemfie screwdriver

- [/] M3 bouten (lengte is draad, zonder kop)
    - Flywheel holder: 3x 25mm
    - SG90 holder: 2x 35mm (ronde kop is belangrijk, met bout)
    - TT motor: 2x 2x 25mm

# Werkgerief
- [ ] Dremel
- [ ] Laptop with Arduino-v2
- [ ] Boor 2mm 7mm
- [ ] Rekkers
- [ ] Lijmpistool
