gfannes/klepto/cart/plast/models/260615_flywheel_nerf_gun/flywheel_2.step

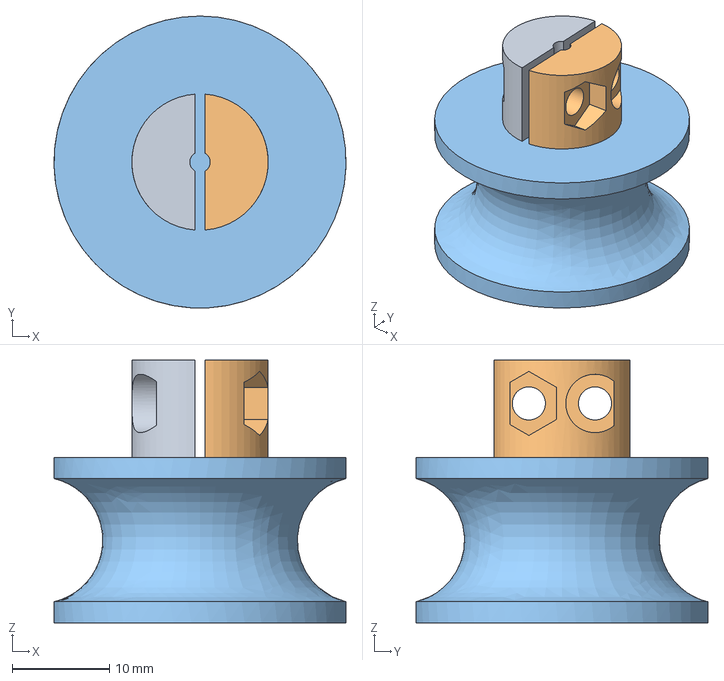
[picture p45: CAD file, 2026-07-31]
cart/plast/models/260615_flywheel_nerf_gun/flywheel_2.step
30.0 x 30.0 x 27.0 mm
