gfannes/klepto/cart/plast/models/260616_ttmotor_holder/motor_holder.step

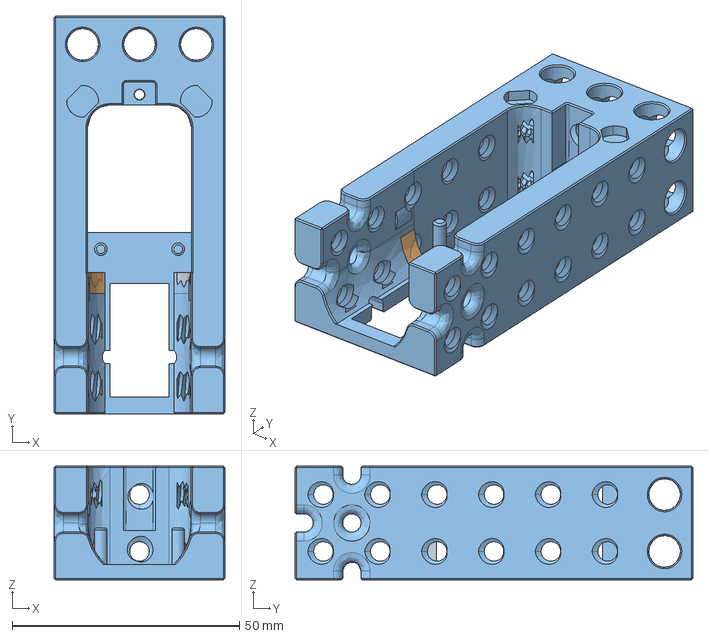
[picture p46: CAD file, 2026-09-12]
cart/plast/models/260616_ttmotor_holder/motor_holder.step
37.5 x 87.5 x 25.0 mm
