gfannes/klepto/cart/plast/models/260618_flywheel_holder_tester/spacers.step

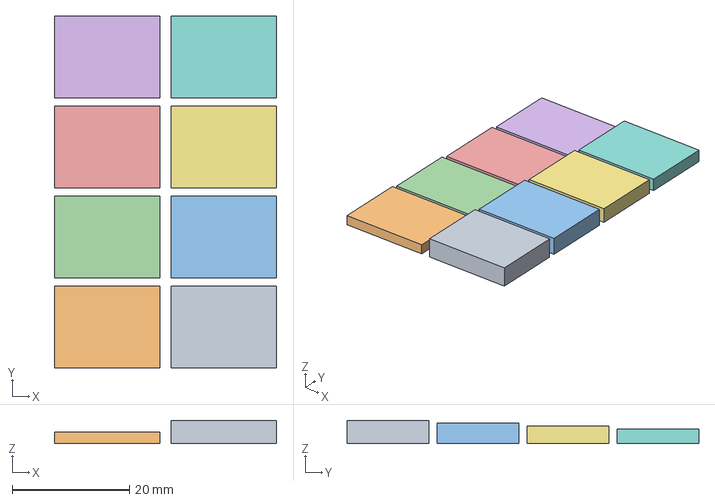
[picture p47: CAD file, 2026-07-31]
cart/plast/models/260618_flywheel_holder_tester/spacers.step
37.9 x 60.0 x 4.00 mm
