gfannes/klepto/cart/plast/models/260619_sg90_horn/horn_b.step

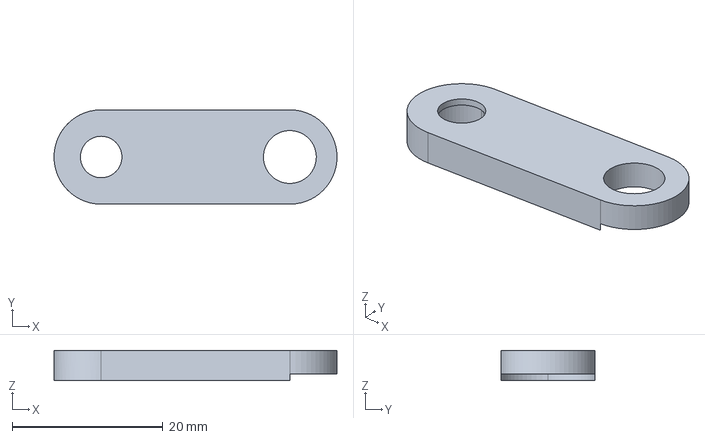
[picture p49: CAD file, 2026-07-31]
cart/plast/models/260619_sg90_horn/horn_b.step
37.5 x 12.5 x 4.00 mm
