gfannes/klepto/cart/plast/models/260705_nerf_shooter/NerfShooter_PartR.step

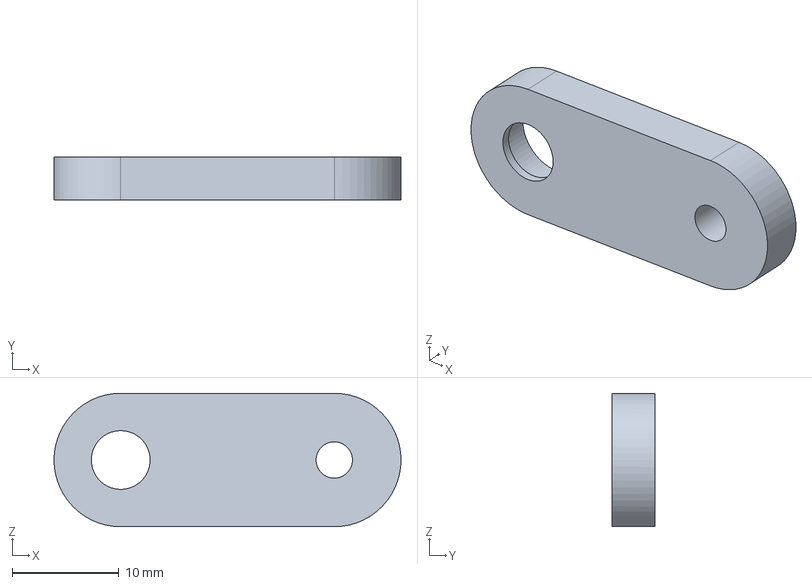
[picture p50: CAD file, 2026-07-31]
cart/plast/models/260705_nerf_shooter/NerfShooter_PartR.step
32.5 x 4.00 x 12.5 mm
