gfannes/klepto/cart/step/freewheel_holder.step

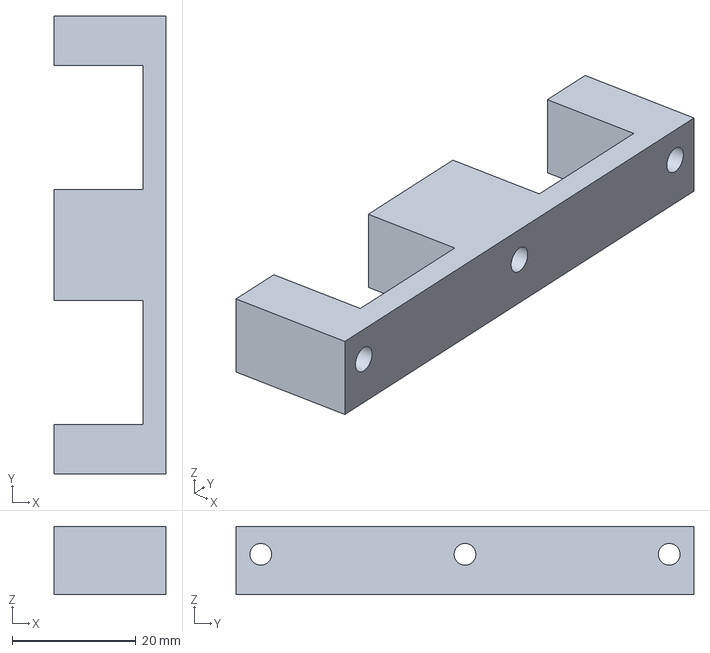
[picture p51: CAD file, 2026-09-12]
cart/step/freewheel_holder.step
18.0 x 73.9 x 11.0 mm
