gfannes/klepto/stemfie/Wheel GND TTRD PLN BU04.00x01.00 - SPN-WHL-0009 (stemfie.org).3mf

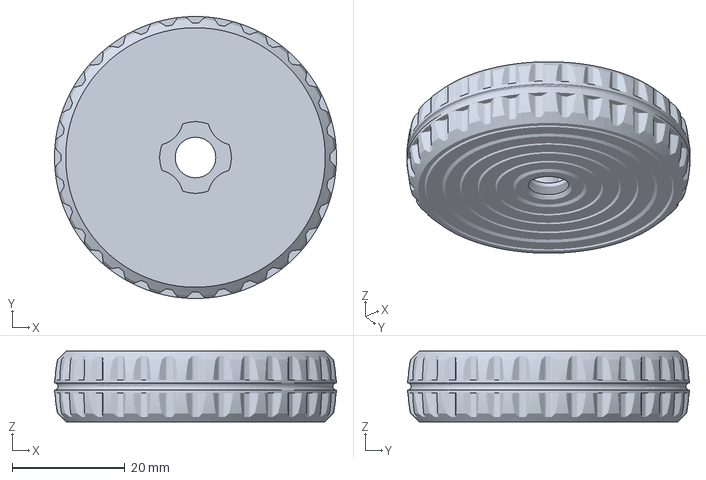
[picture p52: CAD file, 2026-07-10]
stemfie/Wheel GND TTRD PLN BU04.00x01.00 - SPN-WHL-0009 (stemfie.org).3mf
50.0 x 50.0 x 12.5 mm
