gfannes/klepto/cart/plast/models/260615_flywheel_nerf_gun/flywheel_3.step

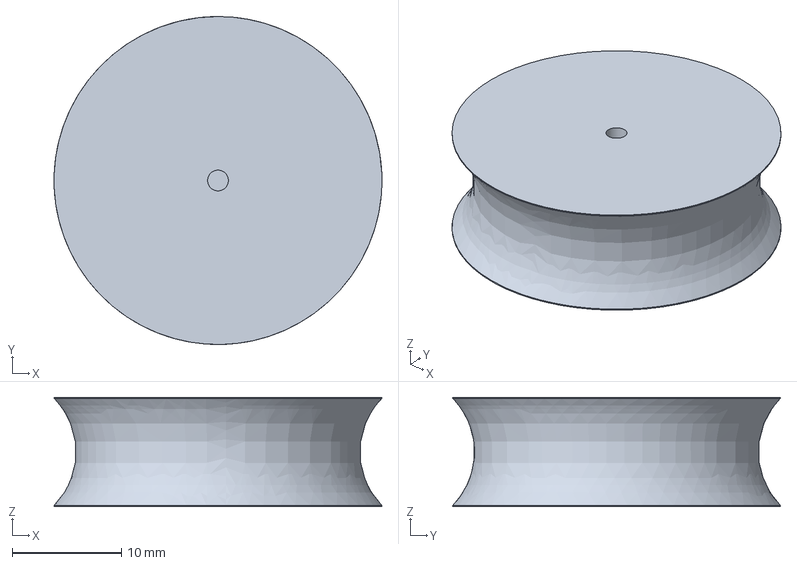
[picture p53: CAD file, 2026-07-31]
cart/plast/models/260615_flywheel_nerf_gun/flywheel_3.step
30.0 x 30.0 x 10.0 mm
