gfannes/klepto/cart/plast/models/260616_ttmotor_holder/motor_holder_4_inv.step

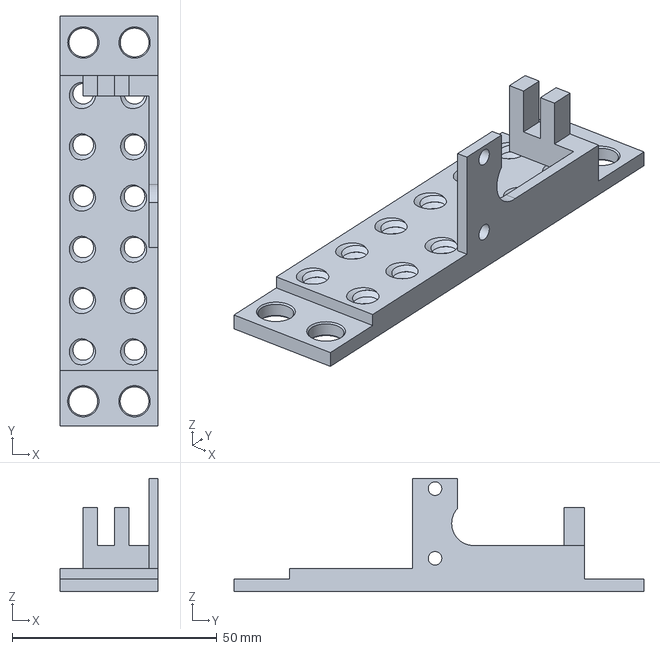
[picture p54: CAD file, 2026-08-09]
cart/plast/models/260616_ttmotor_holder/motor_holder_4_inv.step
24.0 x 100.0 x 27.6 mm
