gfannes/klepto/cart/plast/models/260618_flywheel_holder_tester/flywheel_holder_tester.step

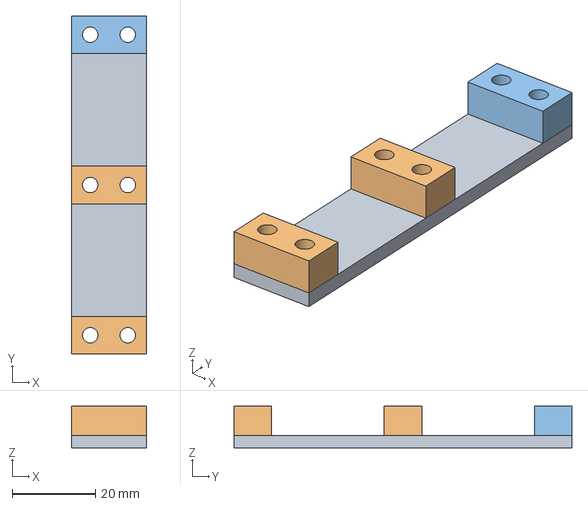
[picture p55: CAD file, 2026-07-31]
cart/plast/models/260618_flywheel_holder_tester/flywheel_holder_tester.step
18.0 x 81.0 x 10.0 mm
