gfannes/klepto/cart/plast/models/260619_sg90_holder/holder_2.step

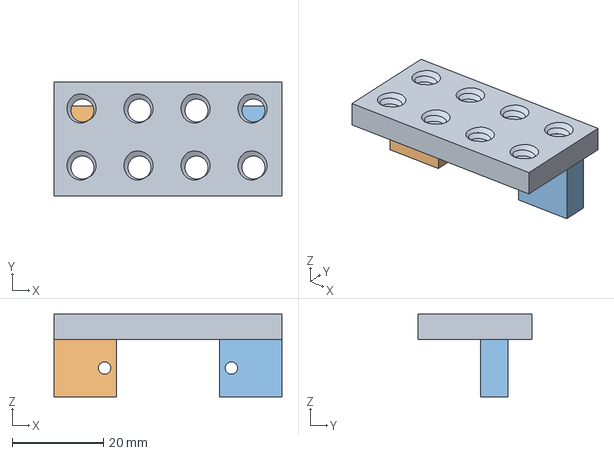
[picture p56: CAD file, 2026-07-31]
cart/plast/models/260619_sg90_holder/holder_2.step
50.0 x 25.0 x 18.1 mm
