gfannes/klepto/cart/plast/models/260705_nerf_shooter/NerfShooter_MotorHolder_c.step

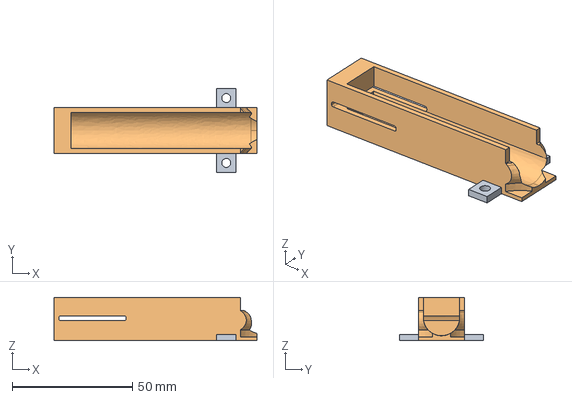
[picture p57: CAD file, 2026-07-31]
cart/plast/models/260705_nerf_shooter/NerfShooter_MotorHolder_c.step
84.5 x 35.0 x 18.0 mm
