gfannes/klepto/cart/step/servo_arm_tilt.step

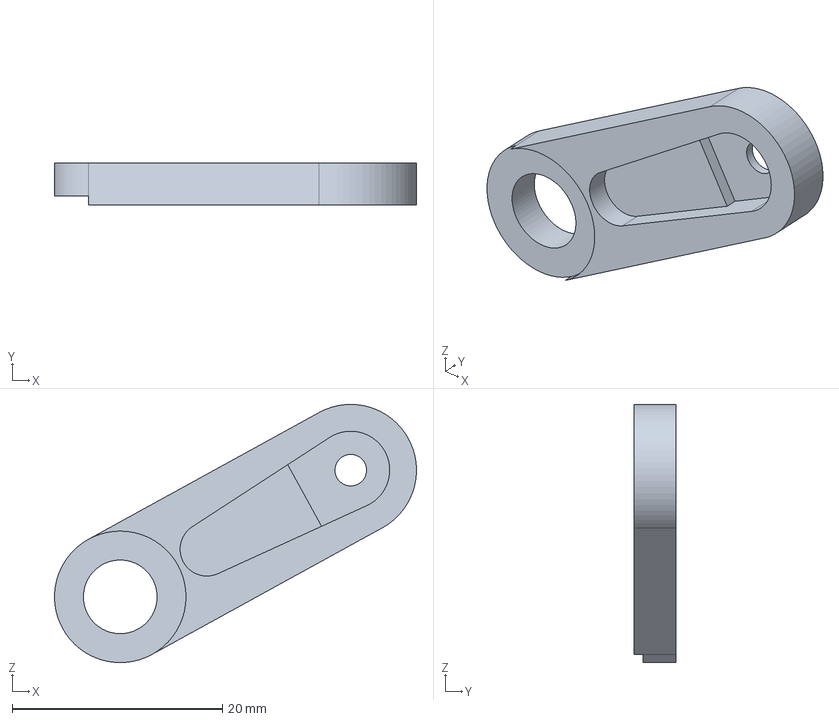
[picture p58: CAD file, 2026-09-12]
cart/step/servo_arm_tilt.step
34.4 x 4.00 x 24.5 mm
