gfannes/klepto/cart/plast/models/260615_flywheel_nerf_gun/flywheel.step

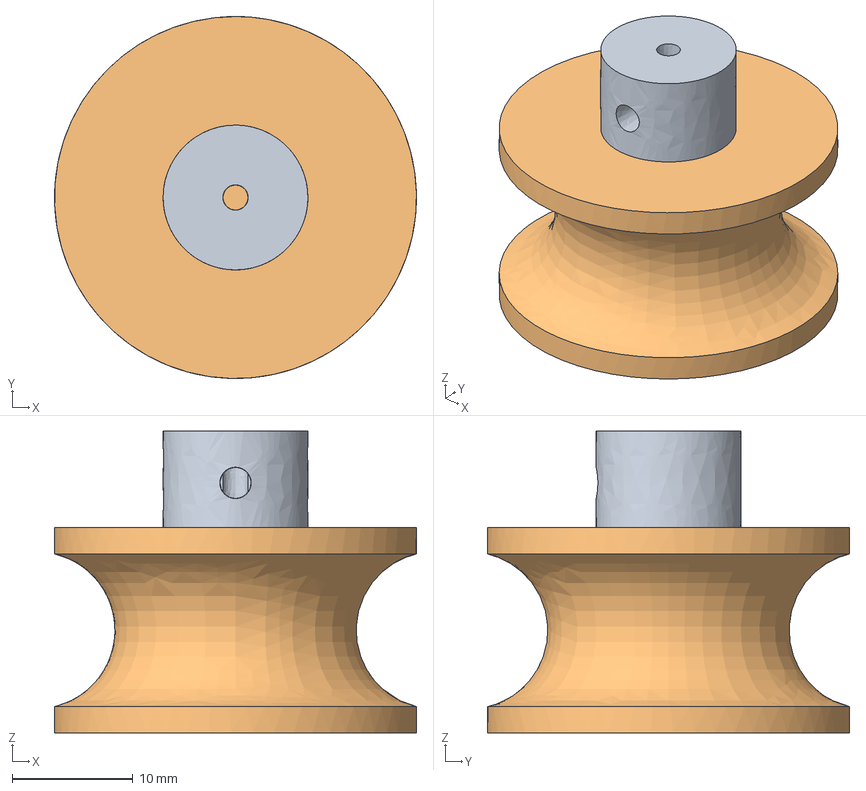
[picture p59: CAD file, 2026-07-31]
cart/plast/models/260615_flywheel_nerf_gun/flywheel.step
30.0 x 30.0 x 25.0 mm
