gfannes/klepto/cart/plast/models/260616_ttmotor_holder/motor_holder_3.step

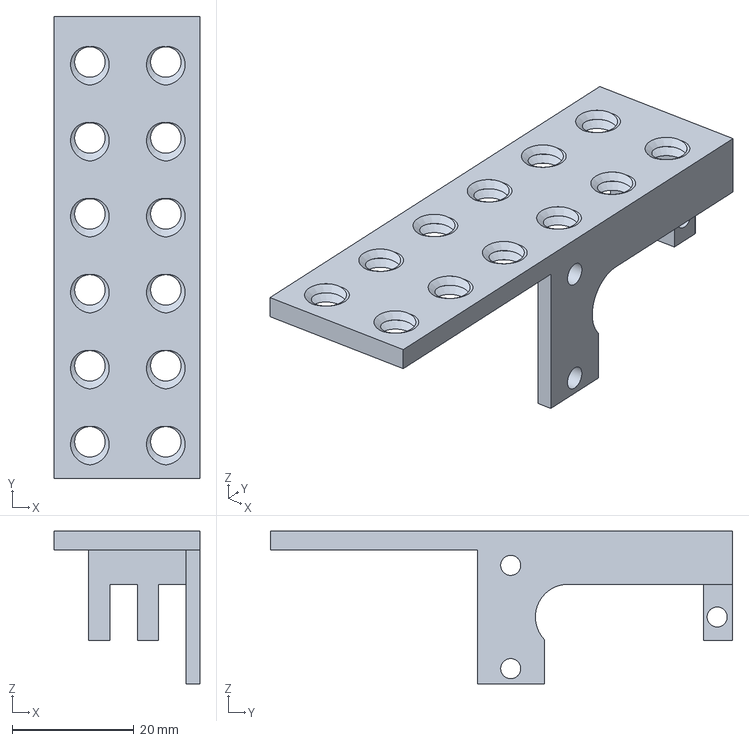
[picture p60: CAD file, 2026-07-31]
cart/plast/models/260616_ttmotor_holder/motor_holder_3.step
24.0 x 76.0 x 25.1 mm
