gfannes/klepto/cart/plast/models/260705_nerf_shooter/NerfShooter_A.step

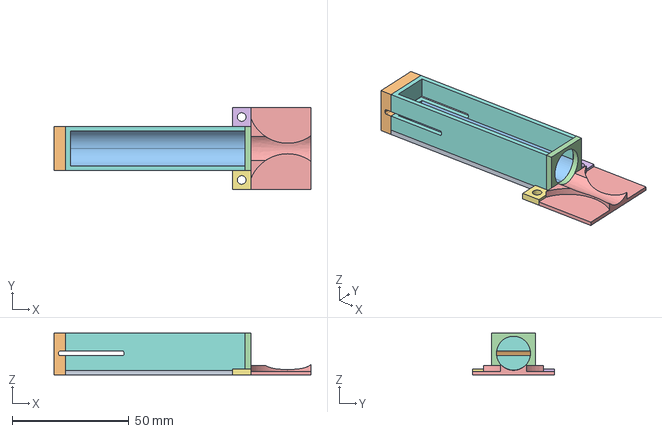
[picture p61: CAD file, 2026-07-31]
cart/plast/models/260705_nerf_shooter/NerfShooter_A.step
110.3 x 35.0 x 18.0 mm
