gfannes/klepto/cart/step/cartridge.step

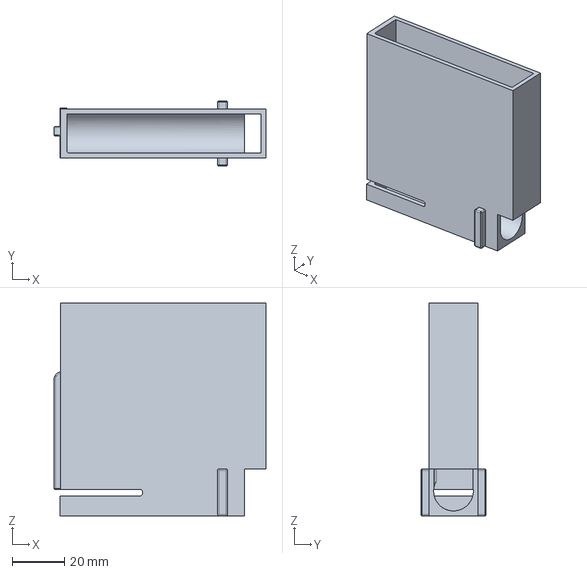
[picture p62: CAD file, 2026-09-12]
cart/step/cartridge.step
81.4 x 25.0 x 81.7 mm
