gfannes/klepto/stemfie/STEMFIE Construction Standard - Template - Block Unit BU01x01x01 - SCS-TPL-0001 (stemfie.org).3mf

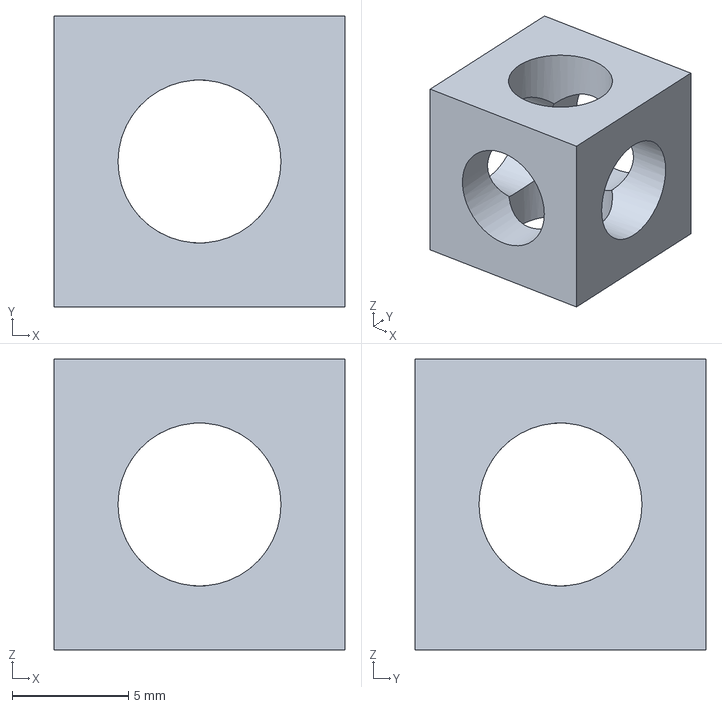
[picture p63: CAD file, 2026-07-10]
stemfie/STEMFIE Construction Standard - Template - Block Unit BU01x01x01 - SCS-TPL-0001 (stemfie.org).3mf
12.5 x 12.5 x 12.5 mm
