gfannes/klepto/cart/step/base.step

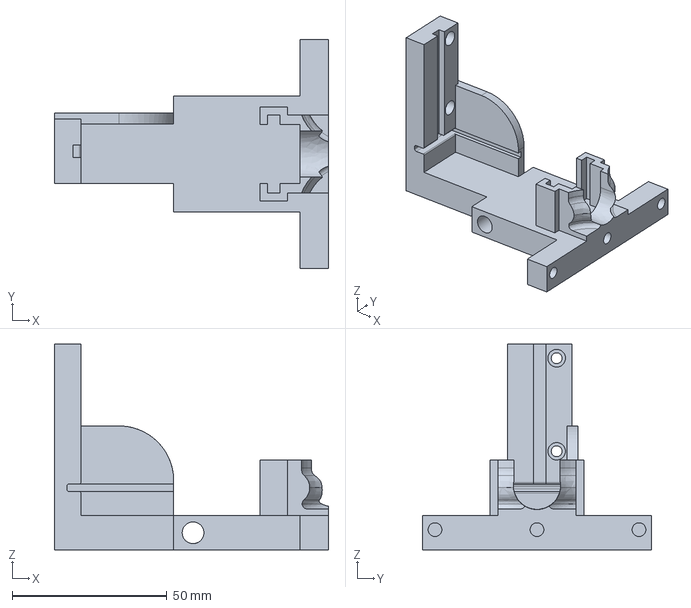
[picture p65: CAD file, 2026-09-12]
cart/step/base.step
88.5 x 73.9 x 66.4 mm
