gfannes/klepto/cart/plast/models/260615_flywheel_nerf_gun/flywheel_3c.step

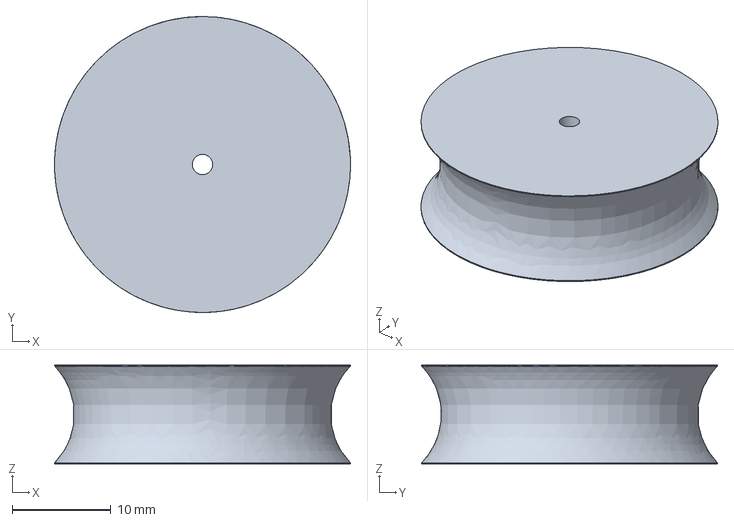
[picture p66: CAD file, 2026-07-31]
cart/plast/models/260615_flywheel_nerf_gun/flywheel_3c.step
30.0 x 30.0 x 10.0 mm
