gfannes/klepto/cart/plast/models/260616_ttmotor_holder/motor_holder_2.step

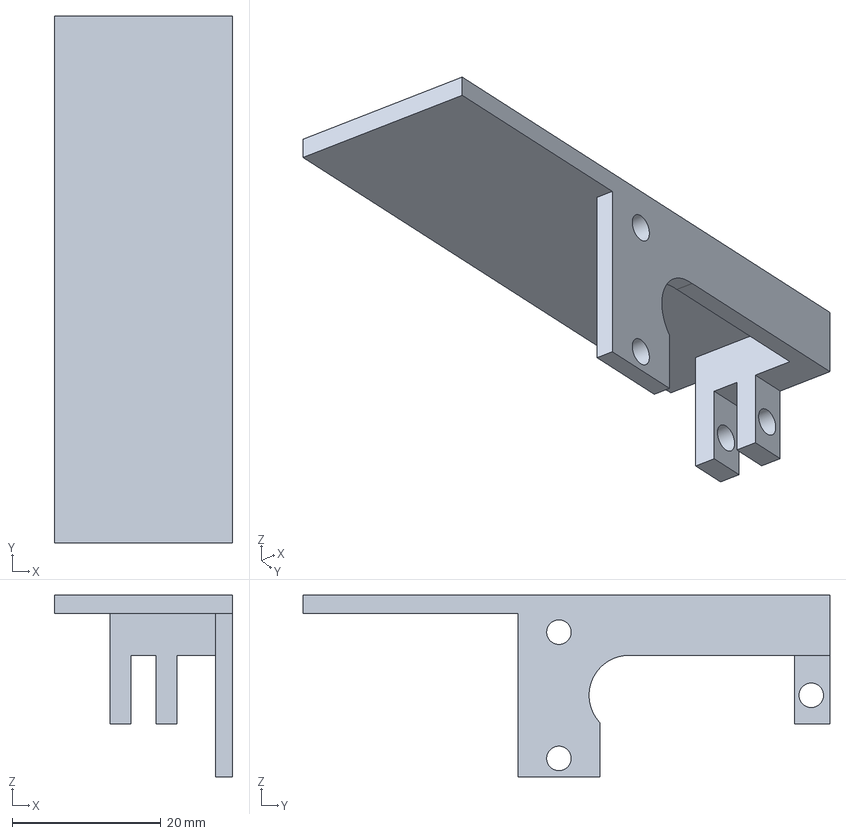
[picture p67: CAD file, 2026-07-31]
cart/plast/models/260616_ttmotor_holder/motor_holder_2.step
24.0 x 71.0 x 24.5 mm
