gfannes/klepto/cart/plast/models/260705_nerf_shooter/NerfShooter_SG90_Holder.step

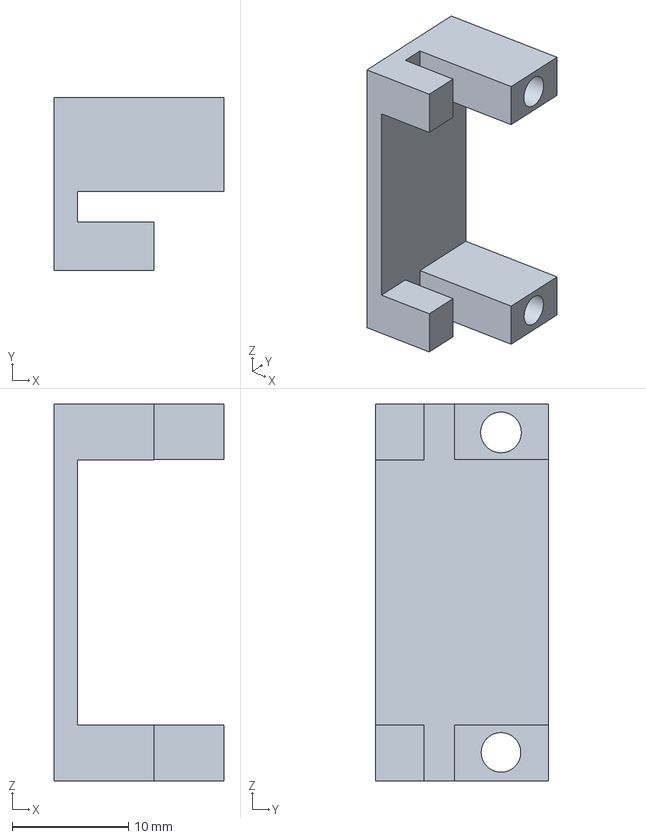
[picture p68: CAD file, 2026-07-31]
cart/plast/models/260705_nerf_shooter/NerfShooter_SG90_Holder.step
14.6 x 14.9 x 32.4 mm
