gfannes/klepto/cart/step/servo_holder.step

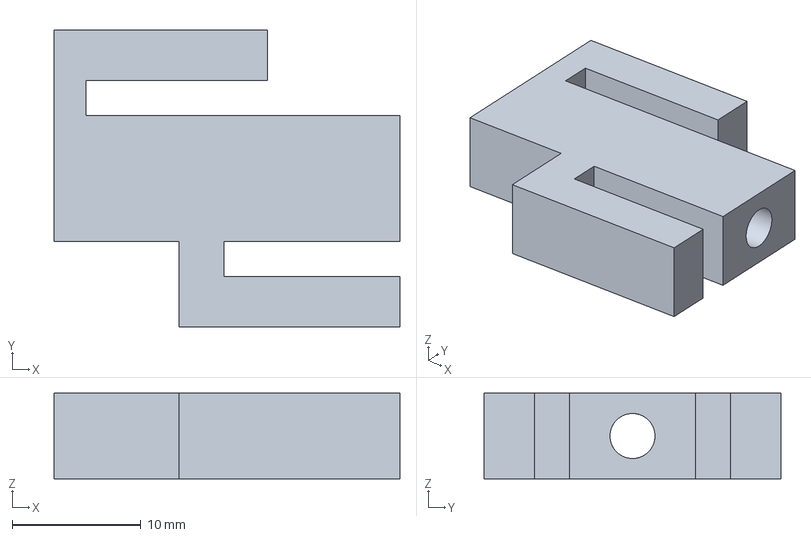
[picture p69: CAD file, 2026-09-12]
cart/step/servo_holder.step
26.9 x 23.1 x 6.66 mm
