gfannes/klepto/stemfie/Pin CL RHD 4mm BU02.50 - SPN-PIN-0050 (stemfie.org).3mf

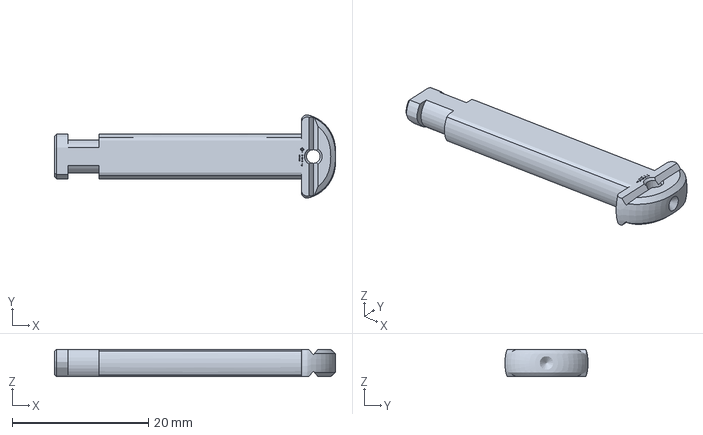
[picture p70: CAD file, 2026-07-10]
stemfie/Pin CL RHD 4mm BU02.50 - SPN-PIN-0050 (stemfie.org).3mf
41.2 x 12.2 x 4.00 mm
