gfannes/klepto/cart/plast/models/260705_nerf_shooter/NerfShooter.step

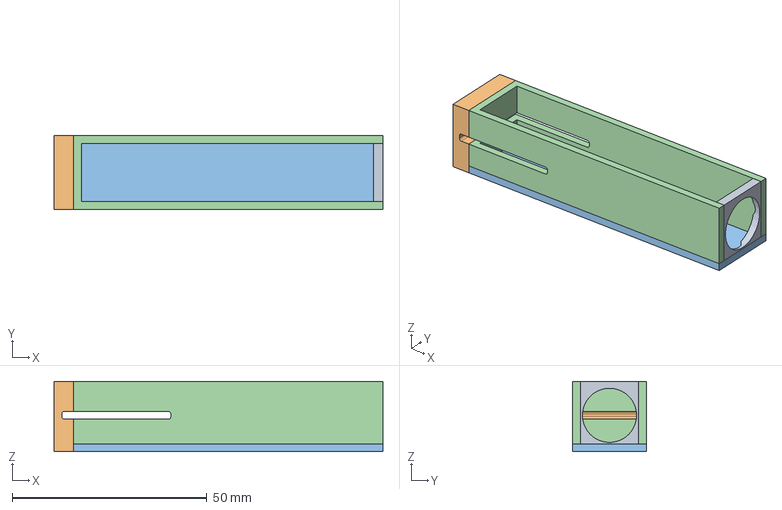
[picture p71: CAD file, 2026-07-31]
cart/plast/models/260705_nerf_shooter/NerfShooter.step
84.5 x 19.0 x 18.0 mm
