gfannes/klepto/cart/step/freewheel.step

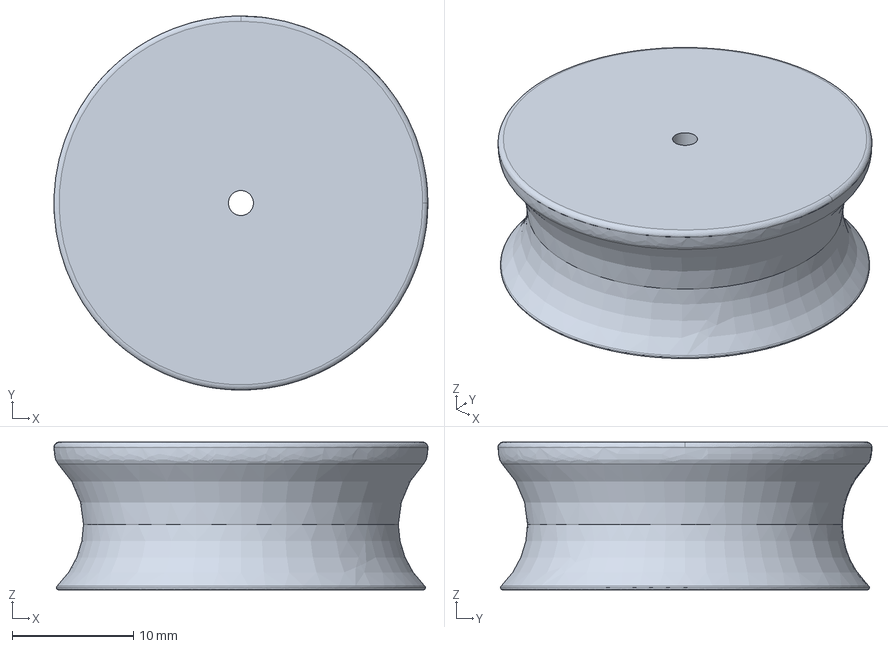
[picture p72: CAD file, 2026-09-12]
cart/step/freewheel.step
30.9 x 30.9 x 12.2 mm
