gfannes/klepto/stemfie/Shaft PLN BU08.75 - SPN-SFT-0035 (stemfie.org).3mf

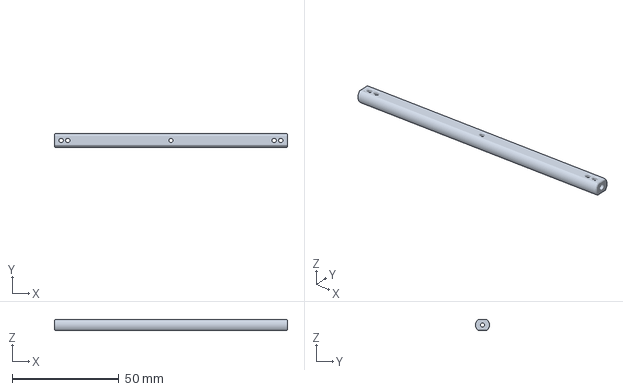
[picture p73: CAD file, 2026-07-10]
stemfie/Shaft PLN BU08.75 - SPN-SFT-0035 (stemfie.org).3mf
109.4 x 6.60 x 5.00 mm
