gfannes/klepto/cart/plast/models/260705_nerf_shooter/NerfShooter_DartsBase.step

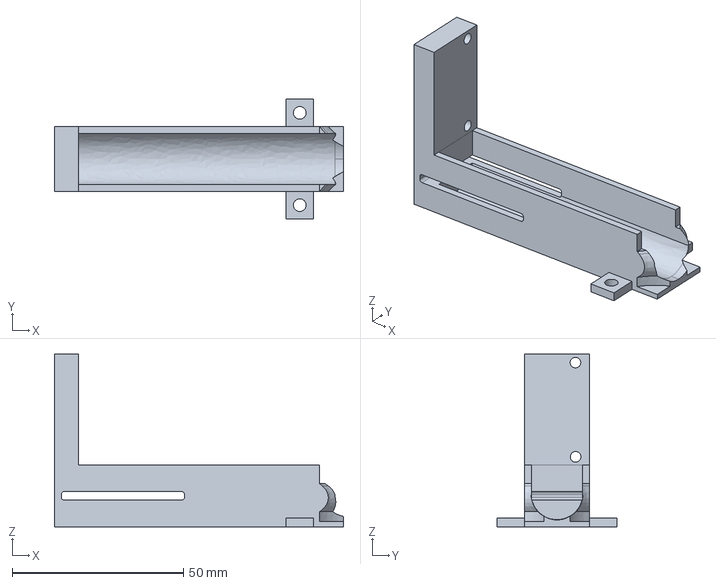
[picture p74: CAD file, 2026-07-31]
cart/plast/models/260705_nerf_shooter/NerfShooter_DartsBase.step
84.5 x 35.0 x 50.5 mm
