gfannes/klepto/cart/step/servo_arm_nerf_pusher.step

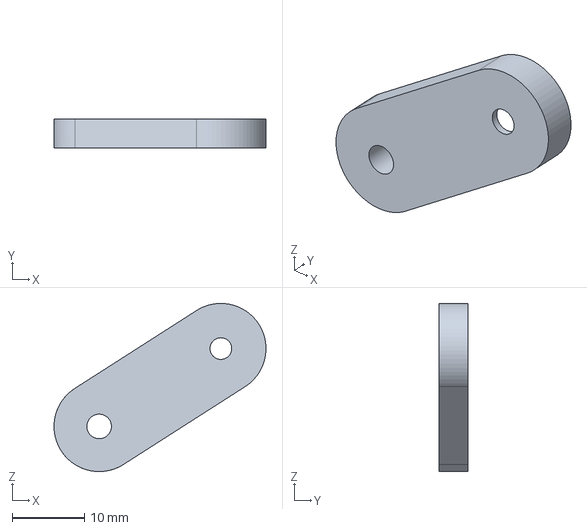
[picture p75: CAD file, 2026-09-12]
cart/step/servo_arm_nerf_pusher.step
29.3 x 4.00 x 23.3 mm
