gfannes/klepto/stemfie/Pin CL RHD 4mm BU01.50 - SPN-PIN-0046 (stemfie.org).3mf

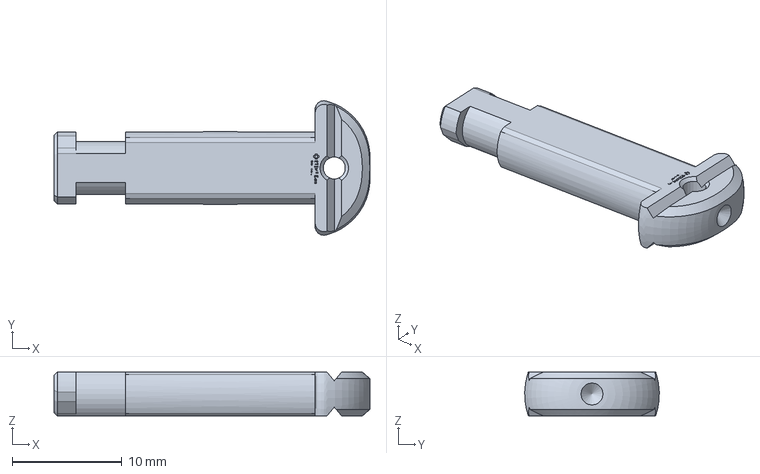
[picture p76: CAD file, 2026-07-10]
stemfie/Pin CL RHD 4mm BU01.50 - SPN-PIN-0046 (stemfie.org).3mf
28.8 x 12.3 x 4.00 mm
