gfannes/klepto/cart/plast/models/260705_nerf_shooter/NerfShooter_PartL.step

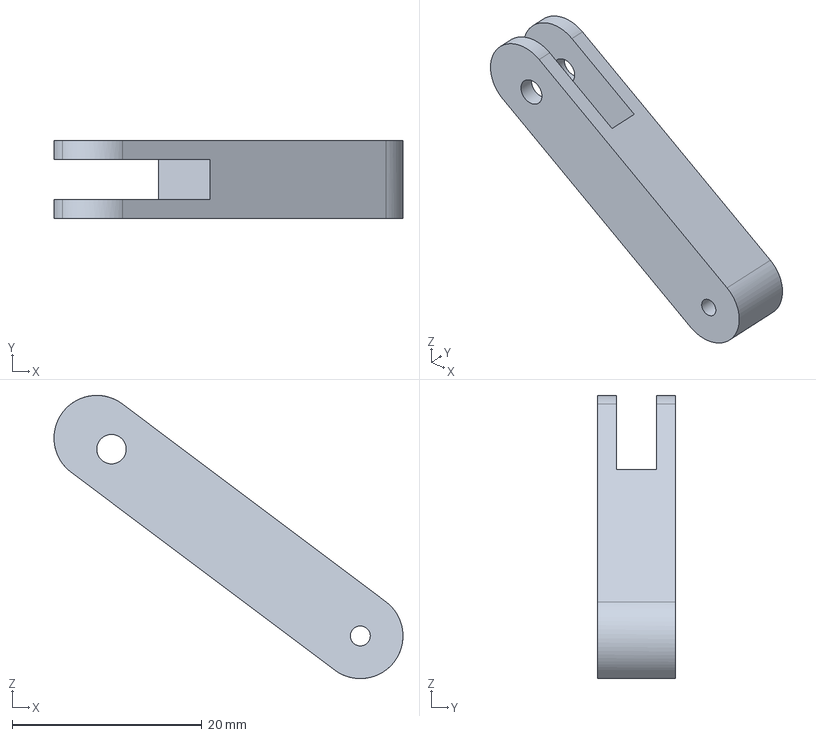
[picture p77: CAD file, 2026-07-31]
cart/plast/models/260705_nerf_shooter/NerfShooter_PartL.step
36.8 x 8.20 x 29.8 mm
