gfannes/klepto/stemfie/Shaft PLN BU08.50 - SPN-SFT-0034 (stemfie.org).3mf

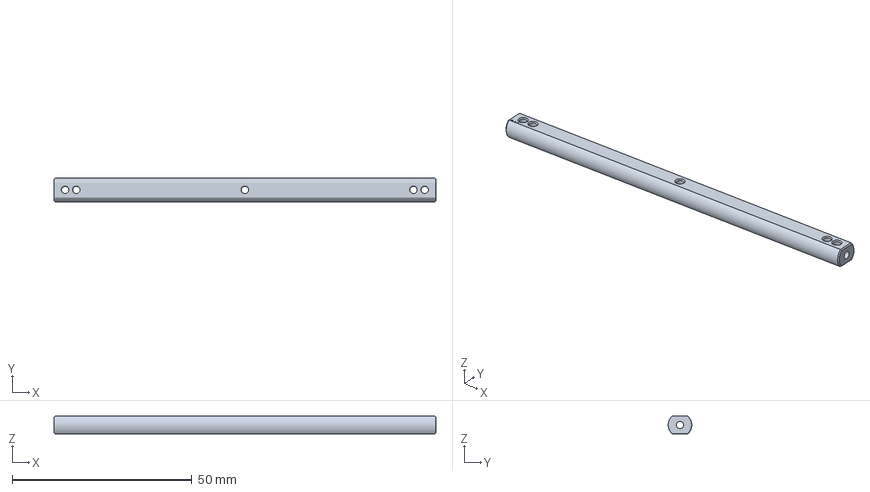
[picture p78: CAD file, 2026-07-10]
stemfie/Shaft PLN BU08.50 - SPN-SFT-0034 (stemfie.org).3mf
106.2 x 6.60 x 5.00 mm
