gfannes/klepto/cart/plast/models/260705_nerf_shooter/NerfShooter_MotorHolder_A.step

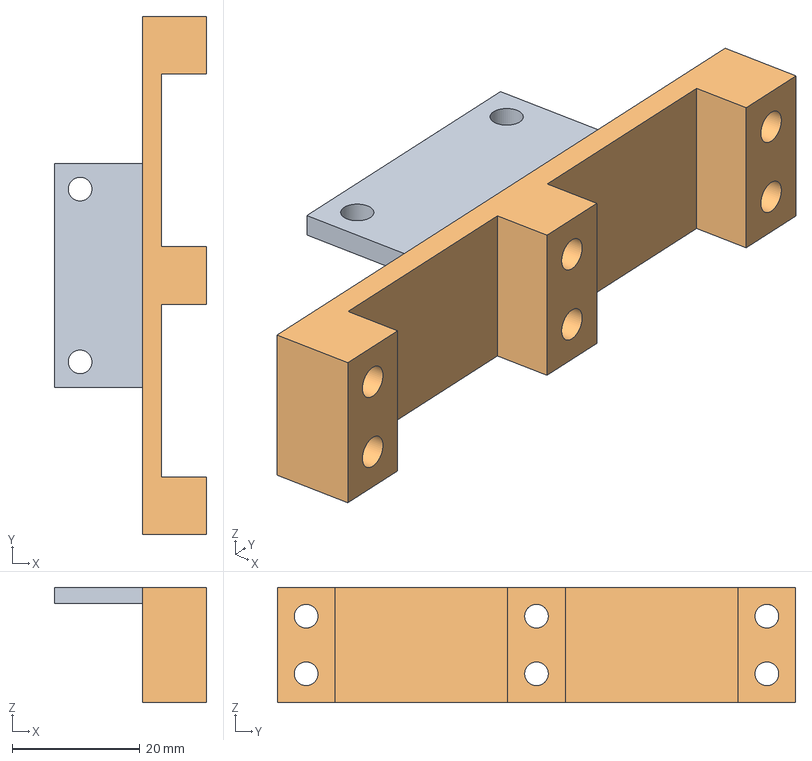
[picture p79: CAD file, 2026-07-31]
cart/plast/models/260705_nerf_shooter/NerfShooter_MotorHolder_A.step
23.8 x 81.0 x 18.0 mm
