gfannes/klepto/stemfie/Pin CL RHD 4mm BU01.25 - SPN-PIN-0045 (stemfie.org).3mf

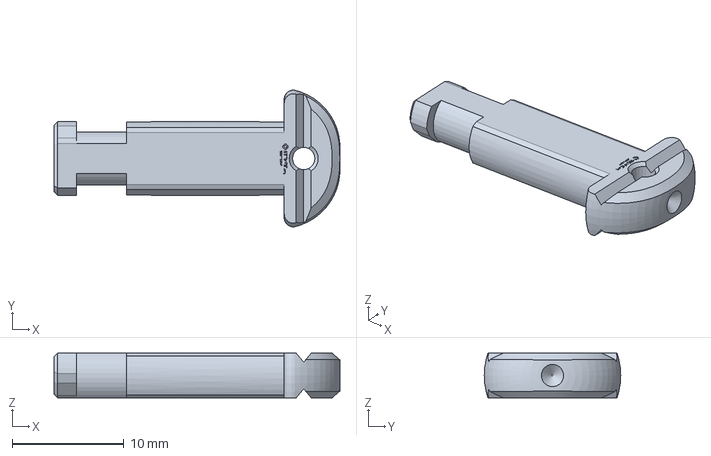
[picture p80: CAD file, 2026-07-10]
stemfie/Pin CL RHD 4mm BU01.25 - SPN-PIN-0045 (stemfie.org).3mf
25.6 x 12.2 x 4.00 mm
