gfannes/klepto/stemfie/STEMFIE Construction Standard - Template - Thread - Female 15mm Stackable [7mm hole Vertical] - SCS-TPL-0019 (stemfie.org).3mf

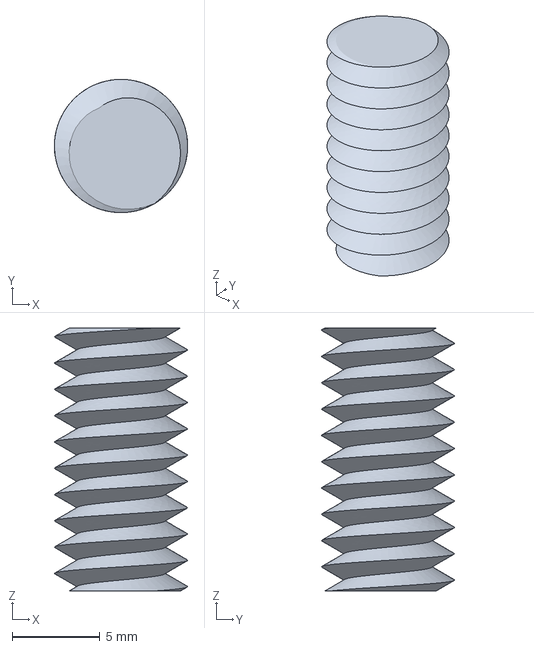
[picture p81: CAD file, 2026-07-10]
stemfie/STEMFIE Construction Standard - Template - Thread - Female 15mm Stackable [7mm hole Vertical] - SCS-TPL-0019 (stemfie.org).3mf
7.61 x 7.60 x 15.0 mm
