gfannes/klepto/stemfie/STEMFIE Construction Standard - Template - Thread - Female 15mm Stackable [7mm hole Horizontal] - SCS-TPL-0018 (stemfie.org).step

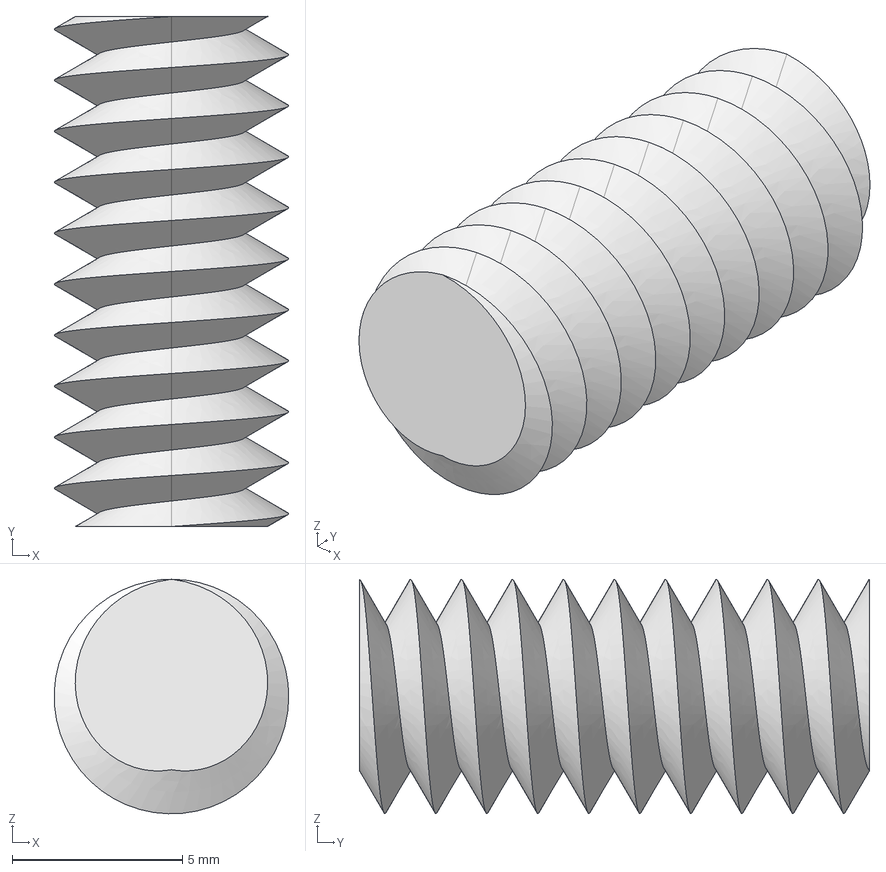
[picture p82: CAD file, 2026-07-10]
stemfie/STEMFIE Construction Standard - Template - Thread - Female 15mm Stackable [7mm hole Horizontal] - SCS-TPL-0018 (stemfie.org).step
6.90 x 15.0 x 6.90 mm
