gfannes/klepto/stemfie/Beam STR STD ERHRH ESS DE BU03x01x01 - SPN-BEM-0802 (stemfie.org).3mf

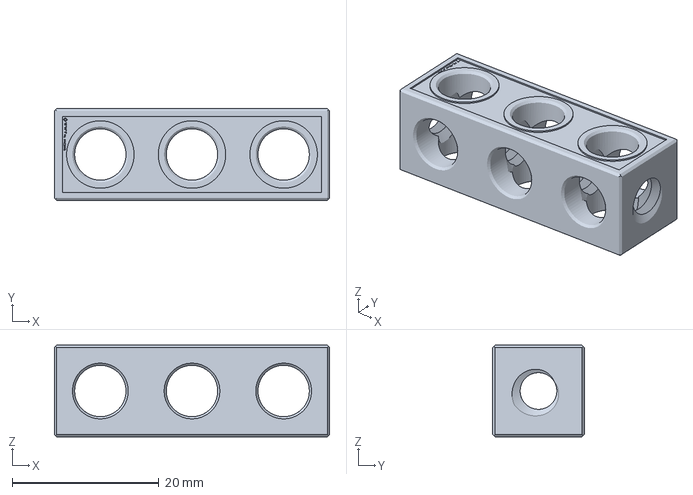
[picture p83: CAD file, 2026-07-10]
stemfie/Beam STR STD ERHRH ESS DE BU03x01x01 - SPN-BEM-0802 (stemfie.org).3mf
37.5 x 12.5 x 12.5 mm
