gfannes/klepto/(list of files, cad)

Other CAD files:
cart/plast/models/260619_sg90_horn/horn_a.step
cart/plast/models/260615_flywheel_nerf_gun/flywheel_3b.step
cart/plast/models/260616_ttmotor_holder/motor_holder_4.step
stemfie/Power-Transmission Hub PLN IDX FRE BU01.00 - SPN-PTH-0103 (stemfie.org).3mf
cart/step/nerf_pusher.step
scad/stemfie.scad
cart/stl/base.stl
cart/stl/cartridge.stl
cart/stl/freewheel.stl
cart/stl/freewheel_holder.stl
cart/stl/nerf_pusher.stl
cart/stl/servo_arm_nerf_pusher.stl
cart/stl/servo_arm_tilt.stl
cart/stl/servo_holder.stl
stemfie/Shoulder Screw RH RHD BU01.00 - SPN-SSC-0044 (stemfie.org).3mf
stemfie/Shoulder Screw RH RHD BU01.50 - SPN-SSC-0046 (stemfie.org).3mf
stemfie/Tool Driver NUT SCR PIN THR - SPN-TOL-0001 (stemfie.org).3mf
