gfannes/klepto/PrintList.md

# Thomas
- [/] 12x shooters
- [/] 24x Motor Holders (thomas, L + R)
- [/] 12x U bracket 3x6x3 (for adding wheels to plate)
- [] bolt 1.25U (om een plankje vast te schroeven op een blok)
- [] bolt 2U (om twee blokken aan elkaar te zetten)

# Geert
- [/] 6x 6x9x1 plate (4)
- [/] 6x 5x9x1 plate (3)
- [/] 24x 3x4 L-beam (14)
- [/] 48x 4x1x1 I-beam (16)
- [/] 12x 11x1 T-beam (4)
- [/] 12x 7x3 T-beam (4)
- [/] 12x Freewheeler (2)
- [/] 72x wheel: na hevige discussie met Pilo lijkt 50mm diameter het beste (48)

# Orphan
- [ ] 48x 2x bolt+nut 0.1mm
