gfannes/klepto/(list of files, drawings)

Other design files:
pcb/layout.fzz
