gfannes/klepto/(commit log)

2026-01-11 MG996R servo mount
    [mg996r_mount.scad, print.scad, stemfie.scad]
2026-06-12 Added servo and DC motor tests
2026-07-10 CAD models for motor mount, wheel fixer, split nut and base plate
    [Beam STR STD ERHRH ESS DE BU03x01x01 - SPN-BEM-0802 (stemfie.org).3mf, Pin CL RHD 4mm BU01.25 - SPN-PIN-0045 (stemfie.org).3mf, Pin CL RHD 4mm BU01.50 - SPN-PIN-0046 (stemfie.org).3mf, Pin CL RHD 4mm BU02.50 - SPN-PIN-0050 (stemfie.org).3mf, Power-Transmission Hub PLN IDX FRE BU01.00 - SPN-PTH-0103 (stemfie.org).3mf, STEMFIE Construction Standard - Template - Block Unit BU01x01x01 - SCS-TPL-0001 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]
2026-07-11 wip on pcb
    [layout.fzz]
2026-07-26 Electronics now fit on 5x5 stemfie with mounting options under the print
2026-07-28 Drill plate
2026-07-28 Update layout after soldering
2026-07-31 Added models for nerf shooter, motor and gs60 attachment to stemfie. Demo code snippets for esp32 send/receive and some basic gs60 control signal
    [NerfShooter.step, NerfShooter_A.step, NerfShooter_DartsBase.step, NerfShooter_MotorHolder_A.step, NerfShooter_MotorHolder_B.step, NerfShooter_MotorHolder_c.step, NerfShooter_PartL.step, NerfShooter_PartR.step]
2026-07-31 Test app for 5x5 board
2026-08-01 Timer issues seem resolved
    [Rover.cpp, rover.ino]
2026-08-01 tilt servo is active
2026-08-01 Using correct pin for tilt, cleanup of ledc
    [Rover.cpp]
2026-08-01 Added new nerf shooter, smaller body (3 blocks with), both servos mounted onto the shooter, flywheels are less sharp
2026-08-02 Added switch
2026-08-07 Print list
2026-08-07 Test for spinners + servos
2026-08-08 Battery holder
2026-08-08 Battery holder 3U
2026-08-09 Writing signal between pcm_min_value and pcm_max_value for engine steering
2026-08-09 Added inverted motor holder
    [motor_holder_4_inv.step]
2026-08-09 Updated print list
2026-08-09 Update PrintList
2026-08-10 Added print list, update sender mac address for receiver, update rover tilt range
    [print_list.ods]
2026-08-11 Updated printlist
    [print_list.ods]
2026-08-11 Using online google sheet
    [print_list.ods]
2026-08-14 Buttons and joystick work, only A and S
2026-08-14 Rename buttons
2026-08-19 Added fillet to wheel fixer
2026-09-12 STL and STEP versions of each part of the shooter 3.0
    [NerfShooter.step, NerfShooter_A.step, NerfShooter_DartsBase.step, NerfShooter_MotorHolder_A.step, NerfShooter_MotorHolder_B.step, NerfShooter_MotorHolder_c.step, NerfShooter_PartL.step, NerfShooter_PartR.step]
